oscarse-git/PSFB_1kW_Prototype/PSFB_PCB/BOM.xlsx

Sheet: BOM
Component | Name | Value | QTY | Price Unit | Need To Buy | Total Cost | URL
Capacitor | 1206B105K500CT | 1u | 12 | 0.72 € | 1 | 8.68 € | https://dk.farnell.com/multicomp-pro/1206b105k500ct/cap-1-f-50v-10-x7r-1206/dp/2497080
Capacitor | LKDM5102J271MF | 270u | 8 |  | 1 | 0.00 €
Capacitor | MAAST32MSB7226MPNA01 | 22u | 3 | 0.50 € | 1 | 1.50 € | https://eu.mouser.com/es/ProductDetail/TAIYO-YUDEN/MAAST32MSB7226MPNA01?qs=FmjOKN4Os876lp2kR04m7Q%3D%3D
Capacitor | C1608X7S1C225K080AE | 2.2u | 2 | 0.29 € | 1 | 0.58 € | https://eu.mouser.com/es/ProductDetail/TDK/C1608X7S1C225K080AE
Capacitor | 1812B104K631CT | 100n | 9 | 0.29 € | 1 | 2.65 € | https://eu.mouser.com/es/ProductDetail/Walsin/1812B104K631CT?qs=fIkAfuXiAQJoiEkNCtFvoQ%3D%3D
Capacitor | GRM1885C1H1R7WA01D | 1.7p | 2 | 0.29 € | 1 | 0.58 € | https://eu.mouser.com/es/ProductDetail/Murata-Electronics/GRM1885C1H1R7WA01D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
Capacitor | CL31B106KAHNNNF | 10u | 2 | 0.24 € | 1 | 0.49 € | https://eu.mouser.com/es/ProductDetail/Samsung-Electro-Mechanics/CL31B106KAHNNNF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
Capacitor | AC0402KPX7R7BB473 | 47n (X7R, 16V) | 4 | 0.05 € | 1 | 0.19 € | https://eu.mouser.com/es/ProductDetail/YAGEO/AC0402KPX7R7BB473
Capacitor | ECA-2EHG010B | 1u 250V | 1 | 0.43 € | 1 | 0.43 € | https://eu.mouser.com/es/ProductDetail/Panasonic-Industry/ECA-2EHG010B
Capacitor | CEU3E2X7R1H473M080AE | 47n (X7R, 50V) | 2 | 0.07 € | 1 | 0.14 € | https://eu.mouser.com/es/ProductDetail/TDK/CEU3E2X7R1H473M080AE?qs=xLDY6iXSiQaAymqHkImCEA%3D%3D
Capacitor | MAJCU168BB7104KTEA01 | 100n (X7R) | 2 | 0.27 € | 1 | 0.53 € | https://eu.mouser.com/es/ProductDetail/TAIYO-YUDEN/MAJCU168BB7104KTEA01?qs=ZcfC38r4PovJ4zMRJqa98Q%3D%3D
Capacitor | KAM31GR71H475KL | 4.7u (X7R) | 2 | 0.55 € | 1 | 1.10 € | https://eu.mouser.com/es/ProductDetail/KYOCERA-AVX/KAM31GR71H475KL?qs=Jm2GQyTW%2FbjSbY1tCxiE1g%3D%3D
Capacitor | 06035C470JAT2A | 47p | 1 | 0.20 € | 1 | 0.20 € | https://eu.mouser.com/es/ProductDetail/KYOCERA-AVX/06035C470JAT2A?qs=ZBeOGGPQgEHmipGwrPVCwg%3D%3D
SiC Diode | C3D10065A | S3D10065A | 4 | 2.60 € | 1 | 10.40 € | https://eu.mouser.com/es/ProductDetail/Wolfspeed/C3D10065A?qs=D3QG1iK7FqgMAdW1WuL7Qg%3D%3D
Diode | STTH1R06A | STTH1R06 | 2 | 0.67 € | 1 | 1.34 € | https://eu.mouser.com/es/ProductDetail/STMicroelectronics/STTH1R06A?qs=kndcJBrKlnTzl3o%252BhwomPg%3D%3D
LED | VLMTG1400-GS08 | LED GREEN | 5 | 0.36 € | 1 | 1.80 € | https://eu.mouser.com/es/ProductDetail/Vishay-Semiconductors/VLMTG1400-GS08
LED | 150120RS75000 | LED RED | 1 | 0.20 € | 1 | 0.20 € | https://eu.mouser.com/es/ProductDetail/Wurth-Elektronik/150120RS75000?qs=2kOmHSv6VfSstSh2FOQbDw%3D%3D
LED | 150120AS75000 | LED AMBAR | 1 | 0.20 € | 1 | 0.20 € | https://eu.mouser.com/es/ProductDetail/Wurth-Elektronik/150120AS75000
TVS Diode | ESD441DPLR | ESD441DPLR | 2 | 0.31 € | 1 | 0.62 € | https://eu.mouser.com/es/ProductDetail/Texas-Instruments/ESD441DPLR?qs=1Kr7Jg1SGW9UQFJqGMkN7Q%3D%3D
Ferrite Bead | BLM18PG121SN1D | FerriteBead | 1 | 0.12 € | 1 | 0.12 € | https://eu.mouser.com/es/ProductDetail/Murata-Electronics/BLM18PG121SN1D?qs=tY8e8KZalarVxhnmnUYZ1A%3D%3D
Current Sensor | TMCS1133B7AQDVGR | TMCS1133B7AQDVGR | 2 | 5.05 € | 1 | 10.10 € | https://eu.mouser.com/es/ProductDetail/Texas-Instruments/TMCS1133B7AQDVGR
Optocoupler | HCNR201-300E | HCNR201-300E | 1 | 5.47 € | 1 | 5.47 € | https://eu.mouser.com/es/ProductDetail/Broadcom-Avago/HCNR201-300E?qs=xnajaXqBF9%2Fpqjck28%2FBeQ%3D%3D
OpAmp | OPA356AIDBVT | OPA356AIDBVT | 2 | 2.49 € | 1 | 4.98 € | https://eu.mouser.com/es/ProductDetail/Texas-Instruments/OPA356AIDBVT?qs=7nS3%252BbEUL6sNJlEi0818Dw%3D%3D
AND gate | SN74LVC1G08DBVR | SN74LVC1G08DBVR | 1 | 0.10 € | 1 | 0.10 € | https://eu.mouser.com/es/ProductDetail/Texas-Instruments/SN74LVC1G08DBVR?qs=8yeEWhuAOtNjtL049wSCoQ%3D%3D
Comparator | TLV1702AIDGK | TLV1702AIDGK | 1 | 1.88 € | 1 | 1.88 € | https://eu.mouser.com/en/ProductDetail/Texas-Instruments/TLV1702AIDGK
OpAmp | OPA2376AQDRQ1 | OPA2376AQDRQ1 | 2 | 3.00 € | 1 | 6.00 € | https://eu.mouser.com/en/ProductDetail/Texas-Instruments/OPA2376AQDRQ1
Voltage Reg | LTC3639HMSE#PBF | LTC3639HMSE#PBF | 1 | 12.79 € | 1 | 12.79 € | https://eu.mouser.com/es/ProductDetail/Analog-Devices/LTC3639HMSEPBF?qs=hVkxg5c3xu91%2FQQCRu4j6Q%3D%3D
Isolated USB Repeater | ISOUSB111DWXR | ISOUSB111DWXR | 1 | 6.06 € | 1 | 6.06 € | https://eu.mouser.com/es/ProductDetail/Texas-Instruments/ISOUSB111DWXR?qs=Y0Uzf4wQF3msEozH7EwD3g%3D%3D
Buck Converter | TPS561246DRLR | TPS561246DRLR | 1 | 0.21 € | 1 | 0.21 € | https://www.mouser.dk/en/ProductDetail/Texas-Instruments/TPS561246DRLR?qs=IKkN%2F947nfBlLn983Qr7Pw%3D%3D
Screw Terminal | 1546551-2 | Power_Terminal_12V | 1 | 1.72 € | 1 | 1.72 € | https://eu.mouser.com/es/ProductDetail/TE-Connectivity/1546551-2?qs=m%2FhmcwQ75LmjcSTRMY1QVQ%3D%3D
Screw Terminal | 1731734 | Power in out | 2 | 2.92 € | 1 | 5.84 € | https://eu.mouser.com/es/ProductDetail/Phoenix-Contact/1731734?qs=5W%252BNKB25SvJ2jkw4aA1wOA%3D%3D
Pin Header | M20-9994046 | All Debug Pins | 1 | 1.39 € | 1 | 1.39 € | https://eu.mouser.com/es/ProductDetail/Harwin/M20-9994046?qs=sGAEpiMZZMvlX3nhDDO4AAIUUFD6r3d5s80vUO3Nluo%3D
Inductor | 784777471 | 470u | 1 | 2.16 € | 1 | 2.16 € | https://eu.mouser.com/es/ProductDetail/Wurth-Elektronik/784777471?qs=sBf%2Fb4nBSldQtXk2HMFhEg%3D%3D
Inductor | 74437349022 | 2.2uH 12mOhm | 1 | 1.99 € | 1 | 1.99 € | https://eu.mouser.com/es/ProductDetail/Wurth-Elektronik/74437349022?qs=cFlH0mFHHFpHkKN4ohgwvw%3D%3D
Mosfets | R6086YNZ4C13 | R6086YNZ4C13 | 2 | 10.93 € | 1 | 21.86 € | https://eu.mouser.com/es/ProductDetail/ROHM-Semiconductor/R6086YNZ4C13?qs=OcgtsXO%252B3gtDlrXNFpjj%2FQ%3D%3D
Resistor | MR06X7321FTL | 7.23k | 1 | 0.14 € | 1 | 0.14 € | https://eu.mouser.com/es/ProductDetail/Walsin/MR06X7321FTL
Resistor | RC0805JR-07150RL | 150 | 1 | 0.09 € | 1 | 0.09 € | https://eu.mouser.com/es/ProductDetail/YAGEO/RC0805JR-07150RL?qs=KyGMWp10Ukuj2ys2qNRVFA%3D%3D
Resistor | RMC16K303FTP | 30k | 3 | 0.19 € | 1 | 0.57 € | https://eu.mouser.com/es/ProductDetail/Kamaya/RMC16K303FTP
Resistor | RN73R2ATTD3002B25 | 30k | 2 | 0.15 € | 1 | 0.30 € | https://eu.mouser.com/es/ProductDetail/KOA-Speer/RN73R2ATTD3002B25?qs=2WXlatMagcHCGZgT8P9O6w%3D%3D
Resistor | RC0603FR-1333KL | 33k | 1 | 0.09 € | 1 | 0.09 € | https://eu.mouser.com/es/ProductDetail/YAGEO/RC0603FR-1333KL
Resistor | CRCW06031K00FKEI | 1k | 4 | 0.21 € | 1 | 0.86 € | https://eu.mouser.com/es/ProductDetail/Vishay/CRCW06031K00FKEI
Resistor | ERJ-PC3B6800V | 680 | 1 | 0.15 € | 1 | 0.15 € | https://eu.mouser.com/es/ProductDetail/Panasonic-Industry/ERJ-PC3B6800V?qs=G4MbTVxgV4Elo1Xzy%252BH5Rw%3D%3D
Resistor | ERJ-UP3F2R20V | 2.2 | 1 | 0.24 € | 1 | 0.24 € | https://eu.mouser.com/es/ProductDetail/Panasonic-Industry/ERJ-UP3F2R20V?qs=y9%2FpVxnqej8wd3GPnjpGVA%3D%3D
Resistor | ERJ-UP6F3R30V | 3.3 | 2 | 0.25 € | 1 | 0.50 € | https://eu.mouser.com/es/ProductDetail/Panasonic-Industry/ERJ-UP6F3R30V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
Resistor | RMC1/16-1002FTP | 10k | 25 | 0.15 € | 1 | 3.65 € | https://eu.mouser.com/es/ProductDetail/Kamaya/RMC1-16-1002FTP
Resistor | 560112116072 | 180k | 1 | 0.09 € |  | 0.09 € | https://eu.mouser.com/es/ProductDetail/Wurth-Elektronik/560112116072
Resistor | 560112116065 | 1.3k | 1 | 0.09 € |  | 0.09 € | https://eu.mouser.com/es/ProductDetail/Wurth-Elektronik/560112116065
Resistor | CR0603-JW-151ELF | 150 | 4 | 0.09 € |  | 0.34 € | https://eu.mouser.com/es/ProductDetail/Bourns/CR0603-JW-151ELF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
Resistor | CR0603-JW-271ELF | 270 | 2 | 0.09 € |  | 0.18 € | https://eu.mouser.com/es/ProductDetail/Bourns/CR0603-JW-271ELF
Resistor | RE0603FRE075K1L | 5.1k | 2 | 0.12 € | 1 | 0.24 € | https://eu.mouser.com/es/ProductDetail/YAGEO/RE0603FRE075K1L
Resistor | RT1206FRE07100KL | 100k | 6 | 0.02 € | 1 | 0.13 € | https://eu.mouser.com/es/ProductDetail/YAGEO/RT1206FRE07100KL
Resistor | RMC1/16K1353FTP | 135k | 1 | 0.15 € |  | 0.15 € | https://eu.mouser.com/es/ProductDetail/Kamaya/RMC1-16K1353FTP?qs=GedFDFLaBXH%2FiaXqy0n1Hw%3D%3D
Resistor | CR0603-JW-182ELF | 1.8k | 1 | 0.09 € | 1 | 0.09 € | https://eu.mouser.com/es/ProductDetail/Bourns/CR0603-JW-182ELF
Potentiometer | PVG3A104C01R00 | 100k | 1 | 1.06 € | 1 | 1.06 € | https://eu.mouser.com/es/ProductDetail/Bourns/PVG3A104C01R00?qs=v12b4BliScycgWcSTRg0kw%3D%3D
Push Button | FSM2JSMAATR | SW_MEC_5G | 1 | 0.28 € | 1 | 0.28 € | https://eu.mouser.com/es/ProductDetail/TE-Connectivity-Alcoswitch/FSM2JSMAATR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
Transformer Core |  | Transformer Core |  |  |  | 0.00 €
MCU | STM32G474CBT6 | STM32G474CBTx | 1 | 7.22 € | 1 | 7.22 € | https://eu.mouser.com/es/ProductDetail/STMicroelectronics/STM32G474CBT6?qs=BJlw7L4Cy79CZZusGsWPhQ%3D%3D
Mosfets | MASTERGAN6TR | MASTERGAN6TR | 2 | 8.03 € | 1 | 16.06 € | https://eu.mouser.com/es/ProductDetail/STMicroelectronics/MASTERGAN6TR?qs=4dK74SdgGtwzDTtkoTE%252BnA%3D%3D
Relay Driver | TPSI3050DWZR | TPSI3050DWZR | 1 | 3.97 € | 1 | 3.97 € | https://eu.mouser.com/es/ProductDetail/Texas-Instruments/TPSI3050DWZR?qs=IPgv5n7u5QZU8a0pRpRx4Q%3D%3D
Optocoupler | ACPL-M61L-000E | ACPL-M61L-000E | 1 | 2.73 € | 1 | 2.73 € | https://eu.mouser.com/es/ProductDetail/Broadcom-Avago/ACPL-M61L-000E?qs=YFzrHcMGcrvOVUT9y59Zbw%3D%3D
 |  |  |  |  |  | 153.51 €
 |  |  |  |  |  | 1146.74 DKK

Sheet: PSFB
Reference | Qty | Value | DNP | Exclude from BOM | Exclude from Board | Footprint | Datasheet
C1,C2,C3,C4,C5,C15,C16,C17,C24,C26,C44,C48 | 12 | 1u |  |  |  | Capacitor_SMD:C_1206_3216Metric | ~
C6,C13,C19 | 3 | 22u |  |  |  | Capacitor_SMD:C_1206_3216Metric | ~
C10,C11,C12,C14,C28,C49,C54,C55 | 8 | 270u |  |  |  | Capacitor_THT:CP_Radial_D25.0mm_P10.00mm_SnapIn | ~
C18,C42 | 2 | 2.2u |  |  |  | Capacitor_SMD:C_0603_1608Metric_Pad1.08x0.95mm_HandSolder | ~
C20,C25,C27,C43,C45,C46,C47,C50,C53 | 9 | 100n |  |  |  | Capacitor_SMD:C_1812_4532Metric | ~
C21,C22 | 2 | 1.7p |  |  |  | Capacitor_SMD:C_0603_1608Metric_Pad1.08x0.95mm_HandSolder | ~
C23,C51 | 2 | 10u |  |  |  | Capacitor_SMD:C_1206_3216Metric | ~
C29 | 1 | C |  |  |  |  | ~
C30,C33,C38,C39 | 4 | 47n (X7R, 16V) |  |  |  | Capacitor_SMD:C_0402_1005Metric | ~
C31 | 1 | 1u 250V |  |  |  | Capacitor_THT:CP_Radial_Tantal_D7.0mm_P5.00mm | ~
C32 | 1 | 10u |  |  |  | Capacitor_SMD:C_1206_3216Metric_Pad1.33x1.80mm_HandSolder | ~
C34,C37 | 2 | 47n (X7R, 50V) |  |  |  | Capacitor_SMD:C_0603_1608Metric | ~
C35,C41 | 2 | 100n (X7R) |  |  |  | Capacitor_SMD:C_0603_1608Metric_Pad1.08x0.95mm_HandSolder | ~
C36,C40 | 2 | 4.7u (X7R) |  |  |  | Capacitor_SMD:C_1206_3216Metric_Pad1.33x1.80mm_HandSolder | ~
C52 | 1 | 47p |  |  |  | Capacitor_SMD:C_0603_1608Metric_Pad1.08x0.95mm_HandSolder | ~
D1,D2,D3,D4 | 4 | S3D10065A |  |  |  | Package_TO_SOT_THT:TO-220-2_Vertical | https://www.wolfspeed.com/media/downloads/73/C3D10065A.pdf
D5,D6 | 2 | STTH1R06 |  |  |  | oscar:DIOM5126X265N | https://www.diodes.com/assets/Datasheets/ds30396.pdf
D7,D8,D9,D14,D15 | 5 | LED GREEN |  |  |  | LED_SMD:LED_0603_1608Metric | ~
D10 | 1 | LED RED |  |  |  | LED_SMD:LED_0603_1608Metric | ~
D11 | 1 | LED AMBAR |  |  |  | LED_SMD:LED_0603_1608Metric | ~
D12,D13 | 2 | ESD441DPLR |  |  |  | oscar:ESD441DPLR | https://www.onsemi.com/pdf/datasheet/esd5z2.5t1-d.pdf
FB1 | 1 | FerriteBead |  |  |  | Resistor_SMD:R_0201_0603Metric | ~
IC1,IC9 | 2 | TMCS1133B7AQDVGR |  |  |  | oscar:TMCS1133B7AQDVGR | https://www.ti.com/product/TMCS1133#design-development
IC2 | 1 | HCNR201-300E |  |  |  | oscar:HCNR201300E | https://datasheet.datasheetarchive.com/originals/distributors/Datasheets-6/DSA-115859.pdf
IC3,IC4 | 2 | OPA356AIDBVT |  |  |  | oscar:SOT95P280X145-5N | http://www.ti.com/lit/gpn/opa356
IC5 | 1 | SN74LVC1G08DBVR |  |  |  | oscar:SOT95P280X145-5N | http://www.ti.com/lit/ds/symlink/sn74lvc1g08.pdf
IC6 | 1 | TLV1702AIDGK |  |  |  | oscar:SOP65P490X110-8N | http://www.ti.com/lit/ds/symlink/tlv1702.pdf
IC7 | 1 | OPA2376AQDRQ1 |  |  |  | SOIC127P600X175-8N | http://www.ti.com/lit/gpn/opa2376-q1
IC8 | 1 | LTC3639HMSE#PBF |  |  |  | oscar:LTC3639HMSEPBF | https://www.analog.com/media/en/technical-documentation/data-sheets/3639fd.pdf
IC10 | 1 | ISOUSB111DWXR |  |  |  | oscar:SOP65P1030X260-16N | https://www.ti.com/lit/ds/symlink/isousb111.pdf?ts=1669697942868
IC11 | 1 | TPS561246DRLR |  |  |  | oscar:SOTFL50P160X60-6N | https://www.ti.com/lit/ds/symlink/tps561246.pdf?ts=1736141056725
IC12 | 1 | TPSI3050DWZR |  |  |  | oscar:SOIC127P1150X280-8N | https://www.ti.com/lit/ds/symlink/tpsi3050.pdf?ts=1725435583662
J2 | 1 | GND_S |  |  |  | Connector_PinHeader_2.54mm:PinHeader_1x01_P2.54mm_Vertical | ~
J3 | 1 | JUMPER_BOOT |  |  |  | Connector_PinHeader_2.54mm:PinHeader_1x02_P2.54mm_Vertical | ~
J4 | 1 | 3.3_PIN_IN_DEBUG |  |  |  | Connector_PinHeader_2.54mm:PinHeader_1x02_P2.54mm_Vertical | ~
J5 | 1 | STLINK_PIN |  |  |  | Connector_PinHeader_2.54mm:PinHeader_1x05_P2.54mm_Vertical | ~
J6 | 1 | USB_C |  |  |  | oscar:UJ20CHGMSMT4BP16TR | https://www.sameskydevices.com/product/resource/uj20-c-h-g-msmt-4b-p16-tr.pdf
J7 | 1 | Power_Terminal_12V |  |  |  | oscar:15465512 | ~
J8 | 1 | 12V_Jumper_for_3.3V |  |  |  | Connector_PinHeader_2.54mm:PinHeader_1x02_P2.54mm_Vertical | ~
J9 | 1 | I_IN_SENSE |  |  |  | Connector_PinHeader_2.54mm:PinHeader_1x01_P2.54mm_Vertical | ~
J10 | 1 | V_IN_SENSE |  |  |  | Connector_PinHeader_2.54mm:PinHeader_1x01_P2.54mm_Vertical | ~
J11 | 1 | I_OUT_SENSE |  |  |  | Connector_PinHeader_2.54mm:PinHeader_1x01_P2.54mm_Vertical | ~
J12 | 1 | V_OUT_SENSE |  |  |  | Connector_PinHeader_2.54mm:PinHeader_1x01_P2.54mm_Vertical | ~
J13 | 1 | V_BAT_SENSE |  |  |  | Connector_PinHeader_2.54mm:PinHeader_1x01_P2.54mm_Vertical | ~
J14 | 1 | GND_SENSE |  |  |  | Connector_PinHeader_2.54mm:PinHeader_1x01_P2.54mm_Vertical | ~
J15 | 1 | CTRL_AH |  |  |  | Connector_PinHeader_2.54mm:PinHeader_1x01_P2.54mm_Vertical | ~
J16 | 1 | CTRL_AL |  |  |  | Connector_PinHeader_2.54mm:PinHeader_1x01_P2.54mm_Vertical | ~
J17 | 1 | CTRL_BL |  |  |  | Connector_PinHeader_2.54mm:PinHeader_1x01_P2.54mm_Vertical | ~
J18 | 1 | CTRL_BH |  |  |  | Connector_PinHeader_2.54mm:PinHeader_1x01_P2.54mm_Vertical | ~
J19 | 1 | HVDC_POWER_IN |  |  |  | oscar:1731734 | ~
J20 | 1 | 5VCC_S |  |  |  | Connector_PinHeader_2.54mm:PinHeader_1x01_P2.54mm_Vertical | ~
J21 | 1 | Vref_S |  |  |  | Connector_PinHeader_2.54mm:PinHeader_1x01_P2.54mm_Vertical | ~
J22 | 1 | VDC_S_SENSE_S |  |  |  | Connector_PinHeader_2.54mm:PinHeader_1x01_P2.54mm_Vertical | ~
J23 | 1 | VOUT_CHARGER |  |  |  | oscar:1731734 | ~
L1 | 1 | 470u |  |  |  | oscar:784777471 | ~
L2 | 1 | 2.2uH 12mOhm |  |  |  | oscar:WE-LHMI_7030_705048 | ~
Q1,Q2 | 2 | R6086YNZ4C13 |  |  |  | Package_TO_SOT_THT:TO-247-3_Vertical | https://ngspice.sourceforge.io/docs/ngspice-html-manual/manual.xhtml#cha_MOSFETs
R1 | 1 | 7.23k |  |  |  | Resistor_SMD:R_0603_1608Metric_Pad0.98x0.95mm_HandSolder | ~
R2 | 1 | 150 |  |  |  | Resistor_SMD:R_0805_2012Metric_Pad1.20x1.40mm_HandSolder | ~
R3,R4 | 2 | 30k |  |  |  | Resistor_SMD:R_0805_2012Metric_Pad1.20x1.40mm_HandSolder | ~
R5 | 1 | 33k |  |  |  | Resistor_SMD:R_0603_1608Metric_Pad0.98x0.95mm_HandSolder | ~
R6,R7,R10,R13 | 4 | 1k |  |  |  | Resistor_SMD:R_0603_1608Metric_Pad0.98x0.95mm_HandSolder | ~
R8 | 1 | 680 |  |  |  | Resistor_SMD:R_0603_1608Metric_Pad0.98x0.95mm_HandSolder | ~
R9,R11,R41 | 3 | 30k |  |  |  | Resistor_SMD:R_0603_1608Metric_Pad0.98x0.95mm_HandSolder | ~
R12 | 1 | 2.2 |  |  |  | Resistor_SMD:R_0603_1608Metric_Pad0.98x0.95mm_HandSolder | ~
R14,R21 | 2 | 3.3 |  |  |  | Resistor_SMD:R_0805_2012Metric_Pad1.20x1.40mm_HandSolder | ~
R15,R16,R17,R18,R19,R20,R24,R25,R39,R44,R45,R46,R47,R48,R49,R50,R51,R52,R53,R54,R55,R56,R57,R58,R59 | 25 | 10k |  |  |  | Resistor_SMD:R_0603_1608Metric_Pad0.98x0.95mm_HandSolder | ~
R22 | 1 | 180k |  |  |  | Resistor_SMD:R_0603_1608Metric_Pad0.98x0.95mm_HandSolder | ~
R23 | 1 | 1.3k |  |  |  | Resistor_SMD:R_0603_1608Metric_Pad0.98x0.95mm_HandSolder | ~
R26,R27,R28,R43 | 4 | 150 |  |  |  | Resistor_SMD:R_0603_1608Metric_Pad0.98x0.95mm_HandSolder | ~
R29,R30 | 2 | 270 |  |  |  | Resistor_SMD:R_0603_1608Metric_Pad0.98x0.95mm_HandSolder | ~
R31,R32 | 2 | 5.1k |  |  |  | Resistor_SMD:R_0603_1608Metric_Pad0.98x0.95mm_HandSolder | ~
R33,R34,R35,R36,R37,R38 | 6 | 100k |  |  |  | Resistor_SMD:R_1206_3216Metric_Pad1.30x1.75mm_HandSolder | ~
R40 | 1 | 135k |  |  |  | Resistor_SMD:R_0603_1608Metric_Pad0.98x0.95mm_HandSolder | ~
R42 | 1 | 1.8k |  |  |  | Resistor_SMD:R_0603_1608Metric_Pad0.98x0.95mm_HandSolder | ~
RV1 | 1 | 100k |  |  |  | oscar:PVG3A104C01R00 | ~
S1 | 1 | FSM2JSMAATR |  |  |  | oscar:FSM2J_1 | https://www.te.com/commerce/DocumentDelivery/DDEController?Action=srchrtrv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
TR1 | 1 | Our Transformer |  |  |  | Transformer_THT:Transformer_Breve_TEZ-28x33 | http://www.breve.pl/pdf/ANG/TEZ_ang.pdf
U1 | 1 | STM32G474CBTx |  |  |  | Package_QFP:LQFP-48_7x7mm_P0.5mm | https://www.st.com/resource/en/datasheet/stm32g474cb.pdf
U2,U4 | 2 | MASTERGAN6TR |  |  |  | oscar:QFN35_9X9_STM-M | https://www.st.com/resource/en/datasheet/mastergan6.pdf
U5 | 1 | ACPL-M61L-000E |  |  |  | oscar:SO-5_AVA-L | ACPL-M61L-000E

Sheet: Hoja1
TR driver | SN6507DGQR | https://www.mouser.com/es/ProductDetail/Texas-Instruments/SN6507DGQR?qs=vvQtp7zwQdOlI8FFS82ezA%3D%3D
TR driver | 750319690 | https://www.mouser.com/es/ProductDetail/Wurth-Elektronik/750319690?qs=1Kr7Jg1SGW%2Fxuc9sXU4Xvg%3D%3D
shocktty | BAT165E6327HTSA1 | https://www.mouser.com/es/ProductDetail/Infineon-Technologies/BAT165E6327HTSA1?qs=K00xGehIljtOiGvGDAvWFg%3D%3D
OPAMP | OPA365AIDBVTG4 | https://www.mouser.com/es/ProductDetail/Texas-Instruments/OPA365AIDBVTG4?qs=pJP364FAHqQWllaZFOaiyA%3D%3D
Vreg | UA78M05CDCYG3 | https://eu.mouser.com/es/ProductDetail/Texas-Instruments/UA78M05CDCYG3
Vreg | TPS561208DDCT | https://eu.mouser.com/es/ProductDetail/Texas-Instruments/TPS561208DDCT?qs=5aG0NVq1C4w3WPddB%252B2yhA%3D%3D
Cap 25V 0.1uF | 08053C104KAT2A | https://eu.mouser.com/es/ProductDetail/KYOCERA-AVX/08053C104KAT2A?qs=EihRZLdKnF2GcTBzDkE%2FiQ%3D%3D
Cap 47uF X7S
Bobina 3.3uH | 784777033 | https://eu.mouser.com/es/ProductDetail/Wurth-Elektronik/784777033?qs=sBf%2Fb4nBSldgShFgH6OSMg%3D%3D
TVS | RCLAMP0521H.C | https://www.mouser.dk/en/ProductDetail/Semtech/RCLAMP0521H.C?qs=jcD%2FCkGBYePZtUEAq397Aw%3D%3D
