oscarse-git/PSFB_1kW_Prototype/Tranformer_Calculator/check/auditoria_168_campos.csv

Referencia | Campo | Valor actual | Valor contrastado | Estado | PDF | Página | Localización | Evidencia / observación | SHA256 PDF
0T42019EC | id | 0T42019EC | 0T42019EC | Coincide | 0T42019EC.pdf | 1 | Specification for |  | 87266b2b87d6918433aff71a38bada4273ee3efb8cc4a9dd238926d39ba48ea0
0T42019EC | Bmax | 0.5 | 0.5 | Coincide | 0T42019EC.pdf | 1 | INDUCTANCE: Test conditions |  | 87266b2b87d6918433aff71a38bada4273ee3efb8cc4a9dd238926d39ba48ea0
0T42019EC | Ae | 29 | 29 | Coincide | 0T42019EC.pdf | 1 | Eff. Parameters: Amin |  | 87266b2b87d6918433aff71a38bada4273ee3efb8cc4a9dd238926d39ba48ea0
0T42019EC | Aw | 25.02 | 25.02 | Coincide | 0T42019EC.pdf | 1 | DIMENSIONS: tabla y dibujo | np.round(3.25 * 7.7, 2) | 87266b2b87d6918433aff71a38bada4273ee3efb8cc4a9dd238926d39ba48ea0
0T42019EC | Ve | 1460 | 1460 | Coincide | 0T42019EC.pdf | 1 | Eff. Parameters: Ve |  | 87266b2b87d6918433aff71a38bada4273ee3efb8cc4a9dd238926d39ba48ea0
0T42019EC | AL | 1540 | 1540 | Coincide | 0T42019EC.pdf | 1 | INDUCTANCE: nominal |  | 87266b2b87d6918433aff71a38bada4273ee3efb8cc4a9dd238926d39ba48ea0
0T42019EC | Ploss | 590 | 590 | Coincide | 0T42019EC.pdf | 1 | CORE LOSSES: PL max individual; 25°C, 100 kHz, 200 mT |  | 87266b2b87d6918433aff71a38bada4273ee3efb8cc4a9dd238926d39ba48ea0
0T44444EC | id | 0T44444EC | 0T44444EC | Coincide | 0T44444EC.pdf | 1 | Specification for |  | 0fd92a081d4de366ace3e511815b4f9ace898e87de8ffbb00830197078c8083e
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
0T40601TC | Ploss | 500 | 500 | Coincide | 0T40601TC.pdf | 1 | CORE LOSSES: PL max individual; 25°C, 100 kHz, 200 mT |  | 2723211623cb77d263b5b4174ed2ae3919ee3ba110f717a5925099e85e5c1a50
