oscarse-git/PSFB_1kW_Prototype/PSFB_PCB/Components/LIB_HCNR201-300E/HCNR201-300E/3D/HCNR201-300E.stp

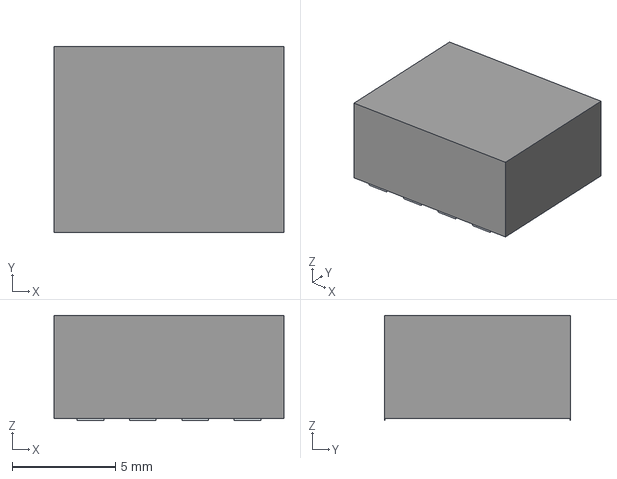
[picture p1: CAD file, 2026-10-29]
PSFB_PCB/Components/LIB_HCNR201-300E/HCNR201-300E/3D/HCNR201-300E.stp
11.2 x 9.00 x 5.10 mm
Pins
