oscarse-git/PSFB_1kW_Prototype/PSFB_PCB/Components/LIB_ISOUSB111DWXR/ISOUSB111DWXR/3D/ISOUSB111DWXR.stp

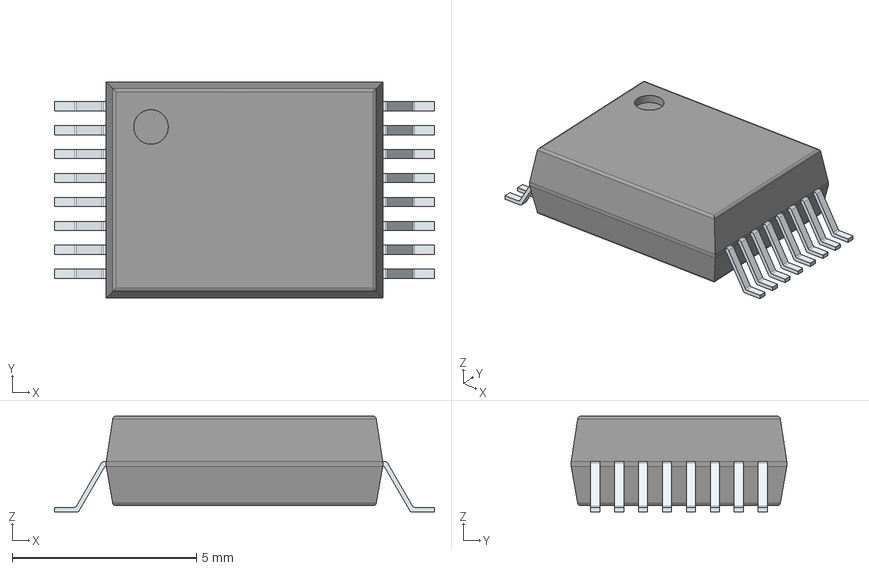
[picture p2: CAD file, 2026-10-29]
PSFB_PCB/Components/LIB_ISOUSB111DWXR/ISOUSB111DWXR/3D/ISOUSB111DWXR.stp
10.3 x 5.85 x 2.60 mm
PinsArrayLR
