oscarse-git/PSFB_1kW_Prototype/PSFB_PCB/Components/LIB_LTC3639HMSE#PBF/LTC3639HMSE#PBF/3D/LTC3639HMSE#PBF.stp

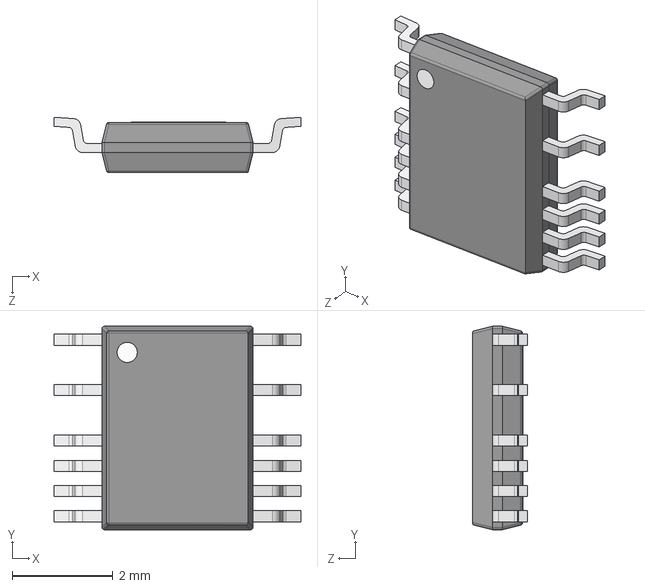
[picture p3: CAD file, 2026-10-29]
PSFB_PCB/Components/LIB_LTC3639HMSE#PBF/LTC3639HMSE#PBF/3D/LTC3639HMSE#PBF.stp
4.90 x 4.04 x 1.10 mm
