oscarse-git/PSFB_1kW_Prototype/PSFB_PCB/Components/LIB_PVG3A104C01R00/PVG3A104C01R00/3D/PVG3A104C01R00.stp

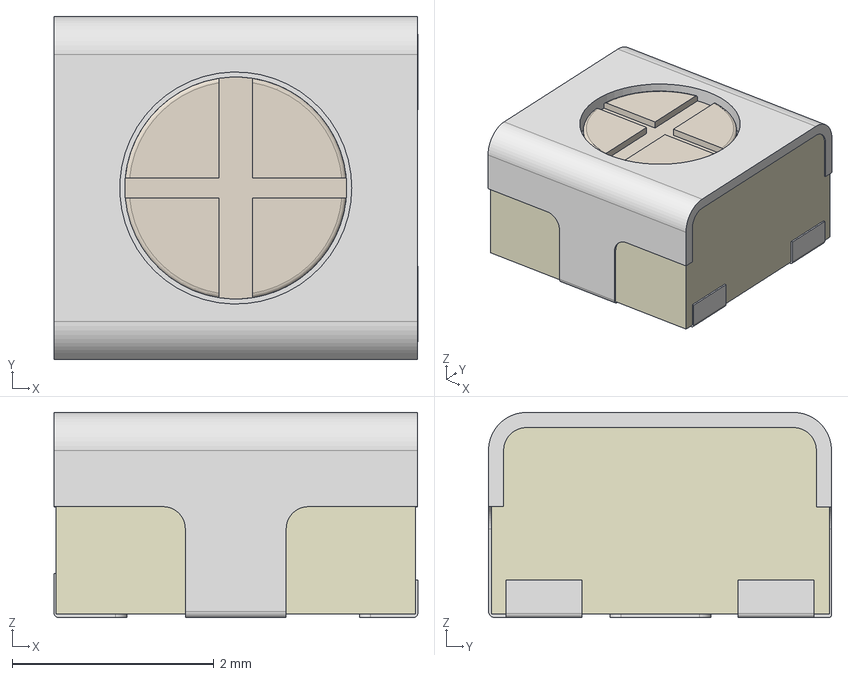
[picture p4: CAD file, 2026-10-29]
PSFB_PCB/Components/LIB_PVG3A104C01R00/PVG3A104C01R00/3D/PVG3A104C01R00.stp
3.60 x 3.40 x 2.03 mm
