oscarse-git/PSFB_1kW_Prototype/PSFB_PCB/Components/LIB_RCLAMP0521H.C/RCLAMP0521H.C/3D/RCLAMP0521H.C.stp

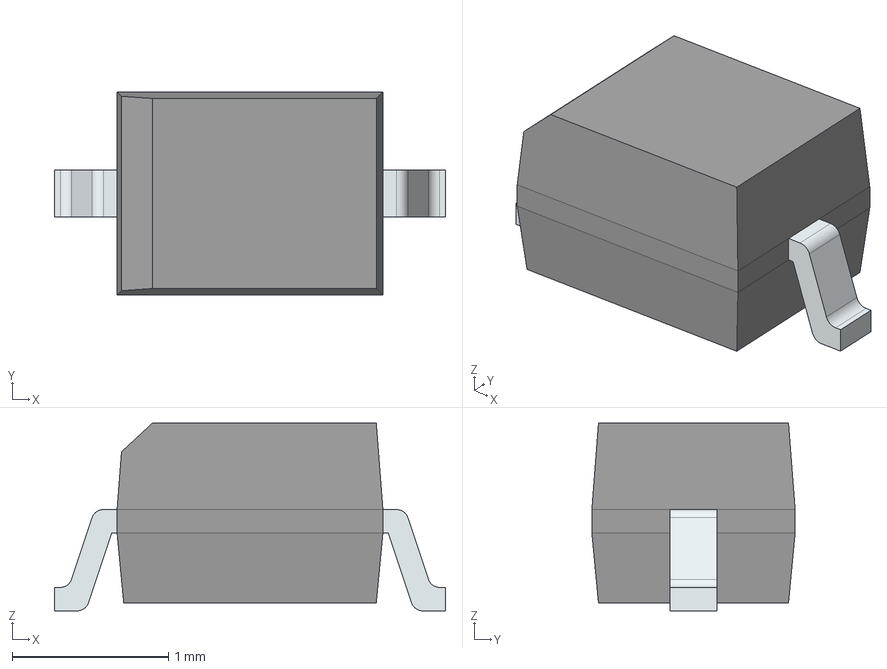
[picture p5: CAD file, 2026-11-10]
PSFB_PCB/Components/LIB_RCLAMP0521H.C/RCLAMP0521H.C/3D/RCLAMP0521H.C.stp
2.50 x 1.30 x 1.20 mm
FilletPinL
FilletPinR
