oscarse-git/PSFB_1kW_Prototype/PSFB_PCB/Components/LIB_TMCS1133B7AQDVGR/TMCS1133B7AQDVGR/3D/TMCS1133B7AQDVGR.stp

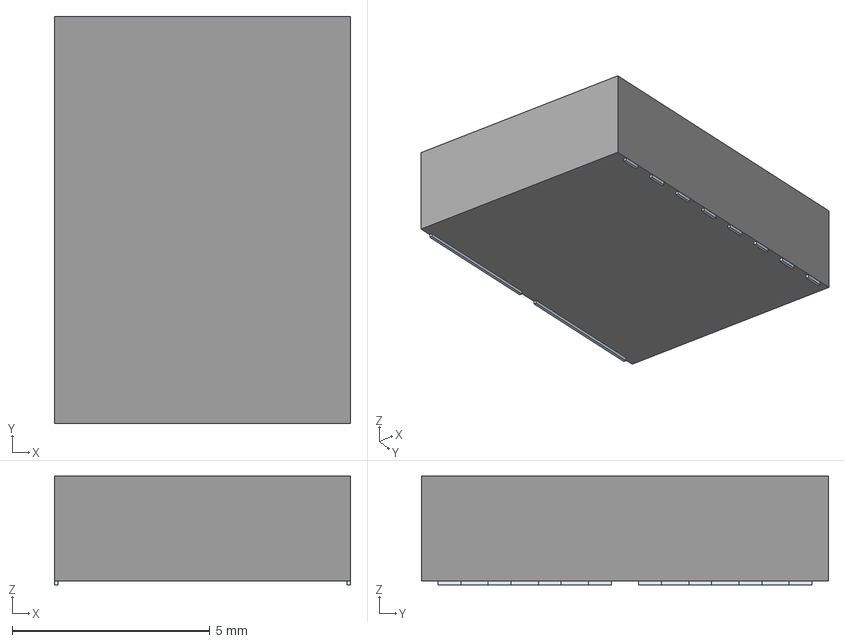
[picture p6: CAD file, 2026-10-29]
PSFB_PCB/Components/LIB_TMCS1133B7AQDVGR/TMCS1133B7AQDVGR/3D/TMCS1133B7AQDVGR.stp
7.50 x 10.3 x 2.75 mm
Pins
