oscarse-git/PSFB_1kW_Prototype/PSFB_PCB/Components/LIB_TPSI3050DWZR/TPSI3050DWZR/3D/TPSI3050DWZR.stp

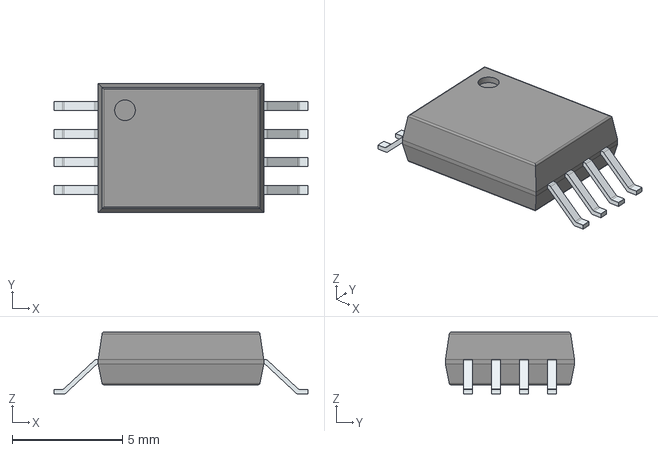
[picture p7: CAD file, 2026-10-29]
PSFB_PCB/Components/LIB_TPSI3050DWZR/TPSI3050DWZR/3D/TPSI3050DWZR.stp
11.5 x 5.85 x 2.80 mm
PinsArrayLR
