oscarse-git/PSFB_1kW_Prototype/PSFB_PCB/Components/LIB_1546551-2/1546551-2/3D/1546551-2.stp

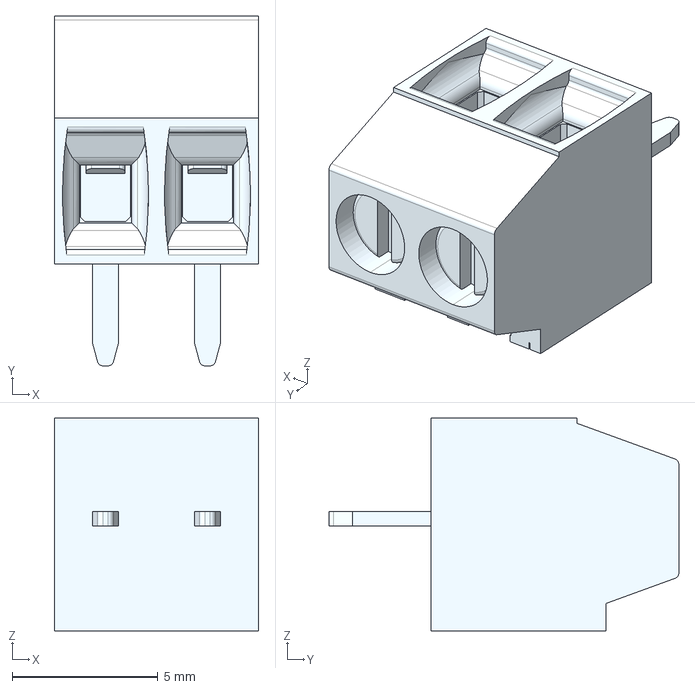
[picture p8: CAD file, 2026-10-29]
PSFB_PCB/Components/LIB_1546551-2/1546551-2/3D/1546551-2.stp
7.00 x 12.0 x 7.30 mm
