oscarse-git/PSFB_1kW_Prototype/PSFB_PCB/Components/LIB_1731734/1731734/3D/1731734.stp

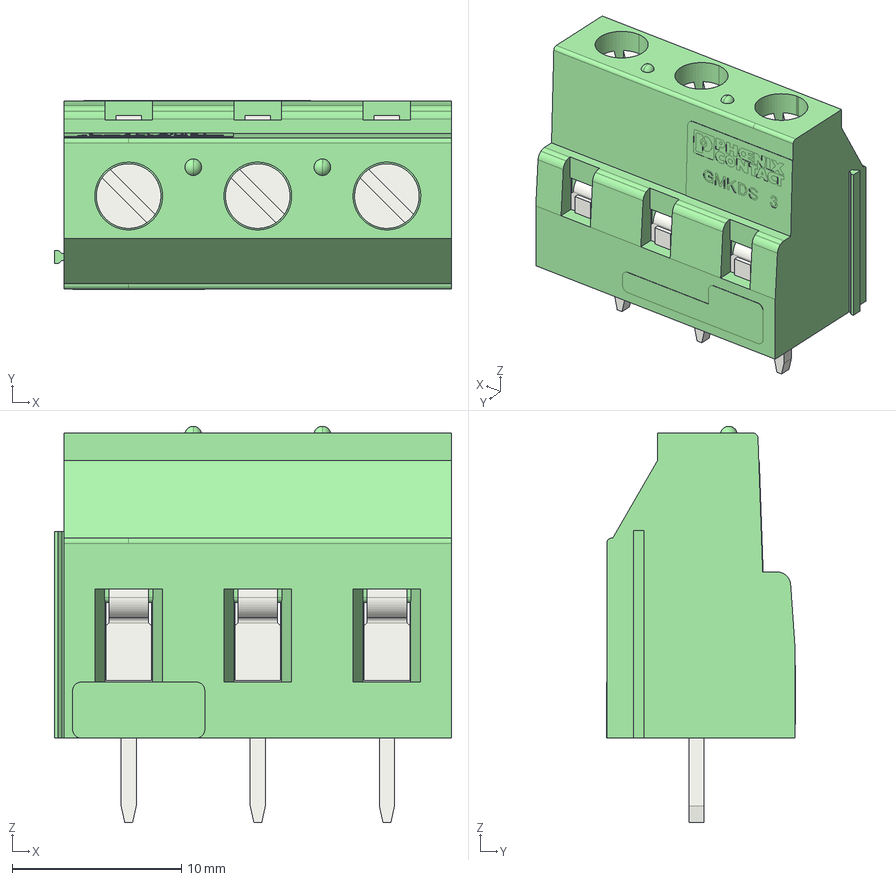
[picture p9: CAD file, 2026-10-29]
PSFB_PCB/Components/LIB_1731734/1731734/3D/1731734.stp
23.4 x 11.2 x 23.4 mm
