oscarse-git/PSFB_1kW_Prototype/PSFB_PCB/Components/LIB_784777033/784777033/3D/784777033.stp

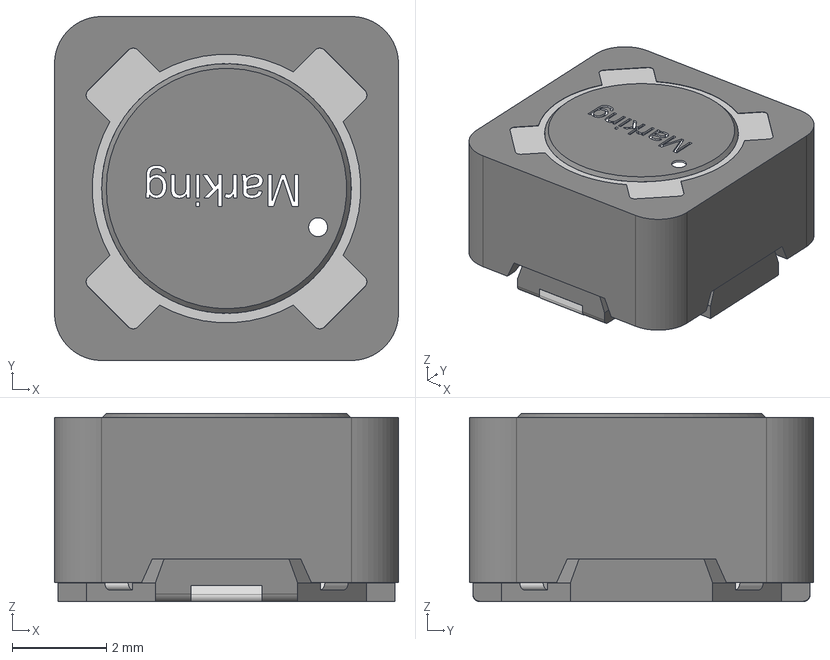
[picture p10: CAD file, 2026-10-30]
PSFB_PCB/Components/LIB_784777033/784777033/3D/784777033.stp
7.30 x 7.30 x 4.00 mm
Ferrite_5.3x3.6
Umspritzung_1
Glue
Ferrite-Ring7.3x3.5x5.7
Leadframe x 2
contact x 4
