oscarse-git/PSFB_1kW_Prototype/(list of files, cad)

Other CAD files:
PSFB_PCB/Components/LIB_RCLAMP0521H.C/RCLAMP0521H.C/Allegro/sod2513x120n.psm
PSFB_PCB/Components/LIB_RCLAMP0521H.C/RCLAMP0521H.C/DEHDL/rclamp0521h.c/chips/chips.prt
