oscarse-git/PSFB_1kW_Prototype/PSFB_PCB/SCH_Schematic1_2026-09-29.pdf

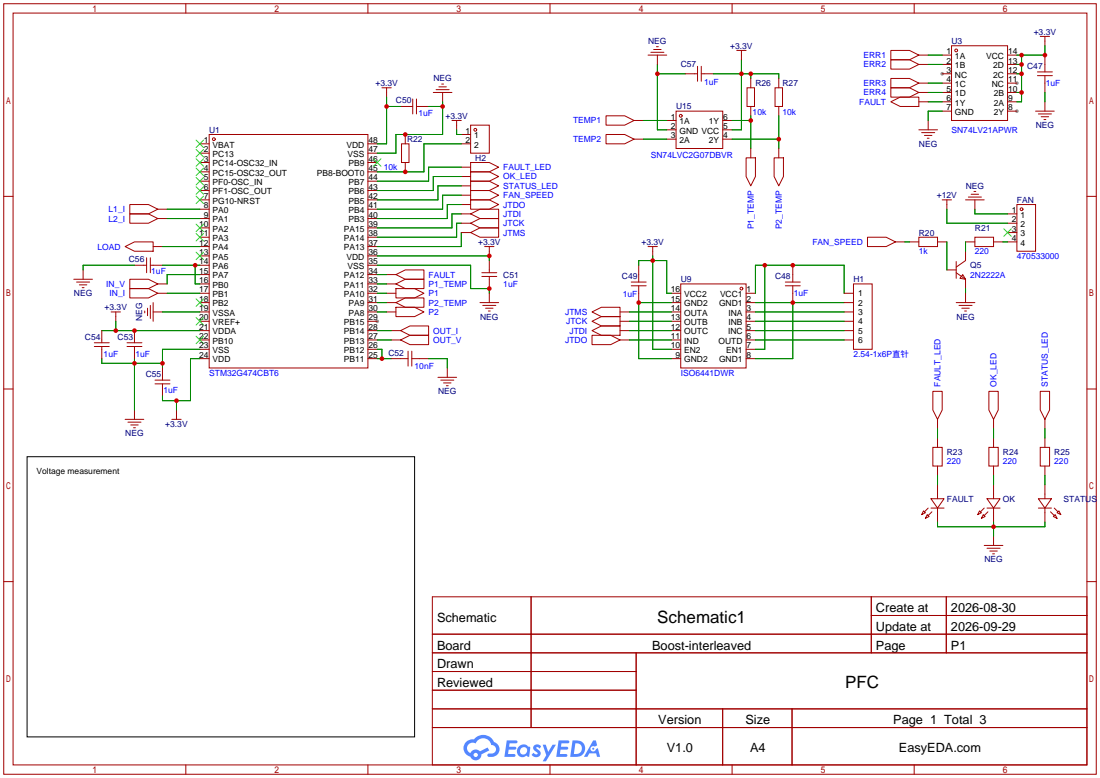
[picture p11: page 1]

EN2 10 IND 11 OUTC 12 OUTB 13 OUTA 14 GND2 15 VCC2 16

Schematic | Schematic1 | Create at | 2026-08-30

Update at | 2026-09-29

Board | Boost-interleaved | Page | P1
Drawn | | PFC
Reviewed

Version | Size | Page 1 Total 3
V1.0 | A4 | EasyEDA.com

# PRE_POS+PRE_POS⁺

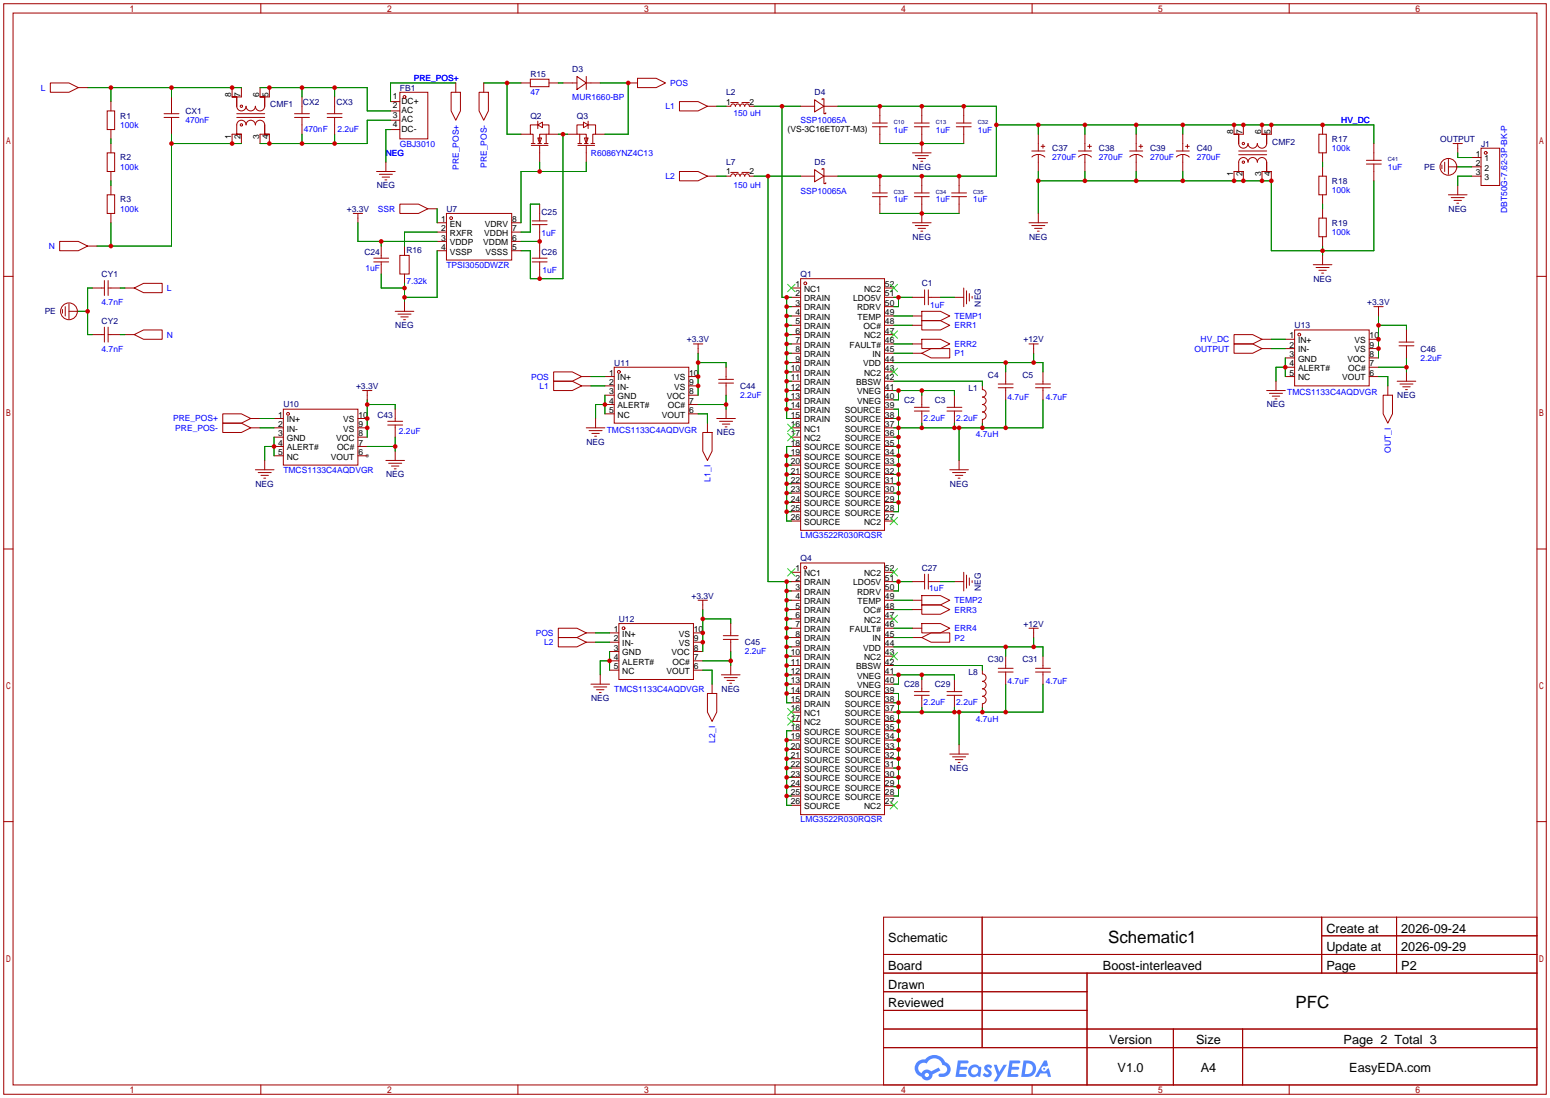
[picture p12: page 2]

DRAIN 2
DRAIN 3
DRAIN 4
DRAIN 5
DRAIN 6
DRAIN 7
DRAIN 8
NC2 27 SOURCE 26 SOURCE 25 SOURCE 24 SOURCE 23 SOURCE 22 SOURCE 21 SOURCE 20 SOURCE 19 SOURCE 18 NC2 17 NC1 16 DRAIN 15 DRAIN 14 DRAIN 13 DRAIN 12 DRAIN 11 DRAIN 10 DRAIN 9

Schematic | Schematic1 | Create at | 2026-09-24

Update at | 2026-09-29

Board | Boost-interleaved | Page | P2
Drawn | | PFC
Reviewed

N1 N2

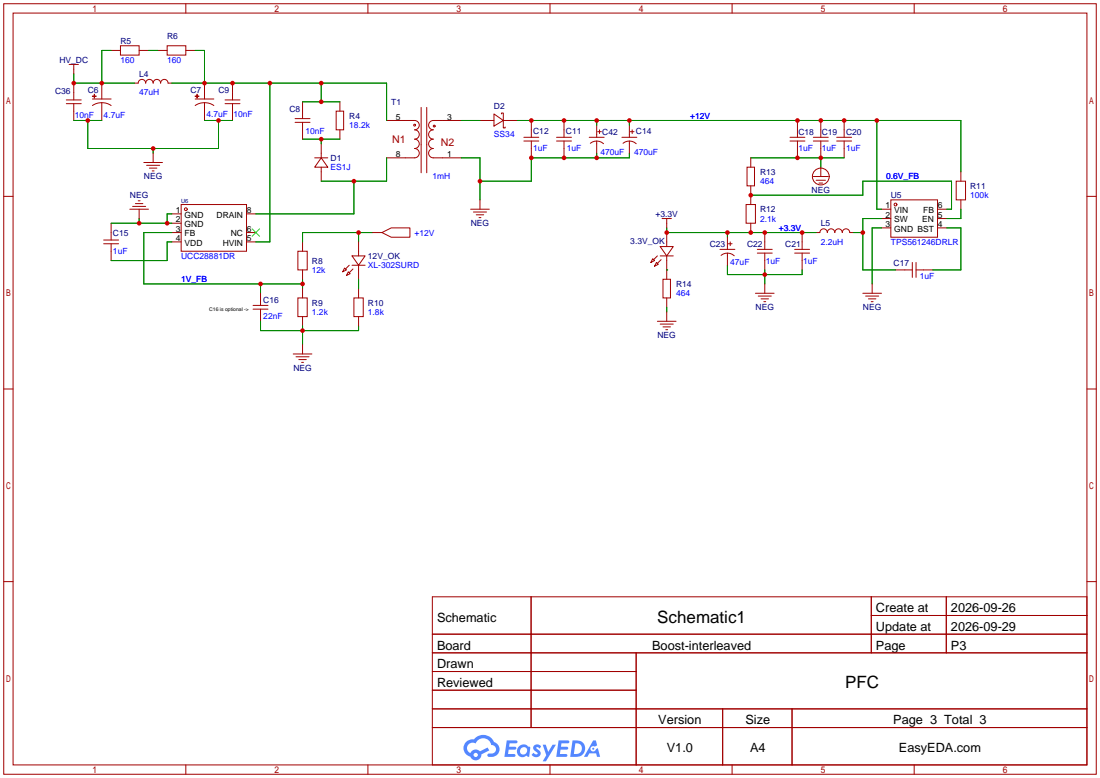
[picture p13: page 3]

Schematic | Schematic1 | Create at | 2026-09-26

Update at | 2026-09-29

Board | Boost-interleaved | Page | P3
Drawn | | PFC
Reviewed
