oscarse-git/PSFB_1kW_Prototype/PSFB_PCB/PSFB.pdf

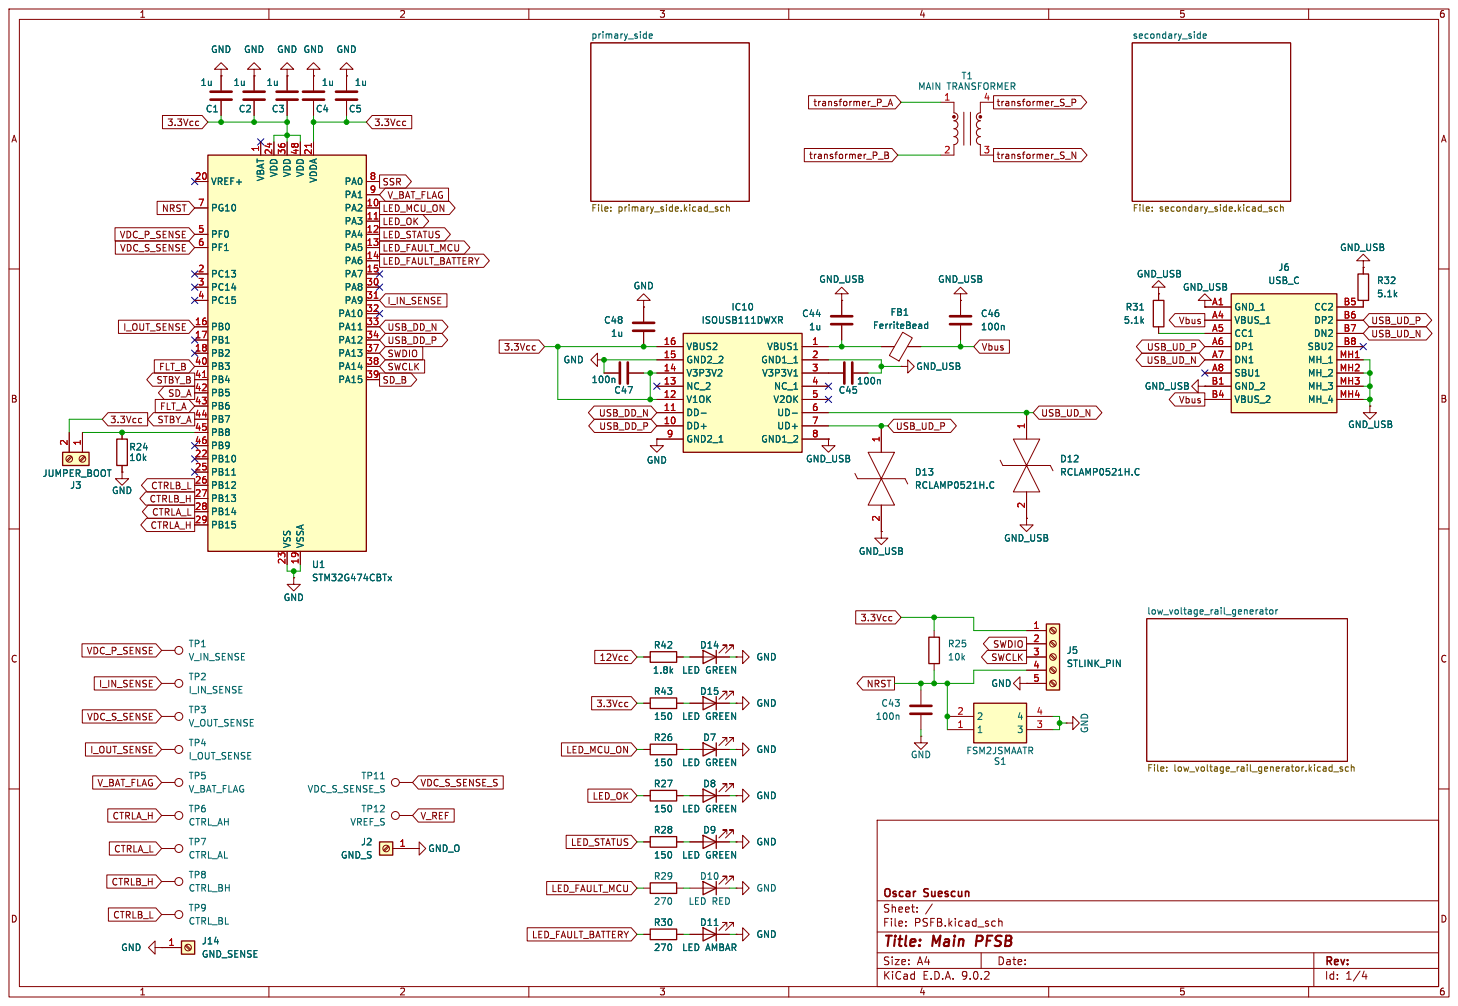
[picture p14: page 1]

1 VDD 24 VDD 36 VSS 23 VDD 48 VSSA 19 VDDA 21 PA0 8 PA1 9 PA2 10 PA3 11 PA4 12 PA5 13 PA6 14 PA7 15 PA8 30 PA9 31 PA10 32 PA11 33 PA12 34 PA13 37 PA14 38 PA15 39 U1STM32G474CBTx C48

1 VDD 24 VDD 36 VSS 23 VDD 48 VSSA 19 VDDA 21 PA0 8 PA1 9 PA2 10 PA3 11 PA4 12 PA5 13 PA6 14 PA7 15 PA8 30 PA9 31 PA10 32 PA11 33 PA12 34 PA13 37 PA14 38 PA15 39 D7

File: PSFB.kicad_sch Sheet: / Oscar Suescun

Id: 1/4 Title: Main PFSB

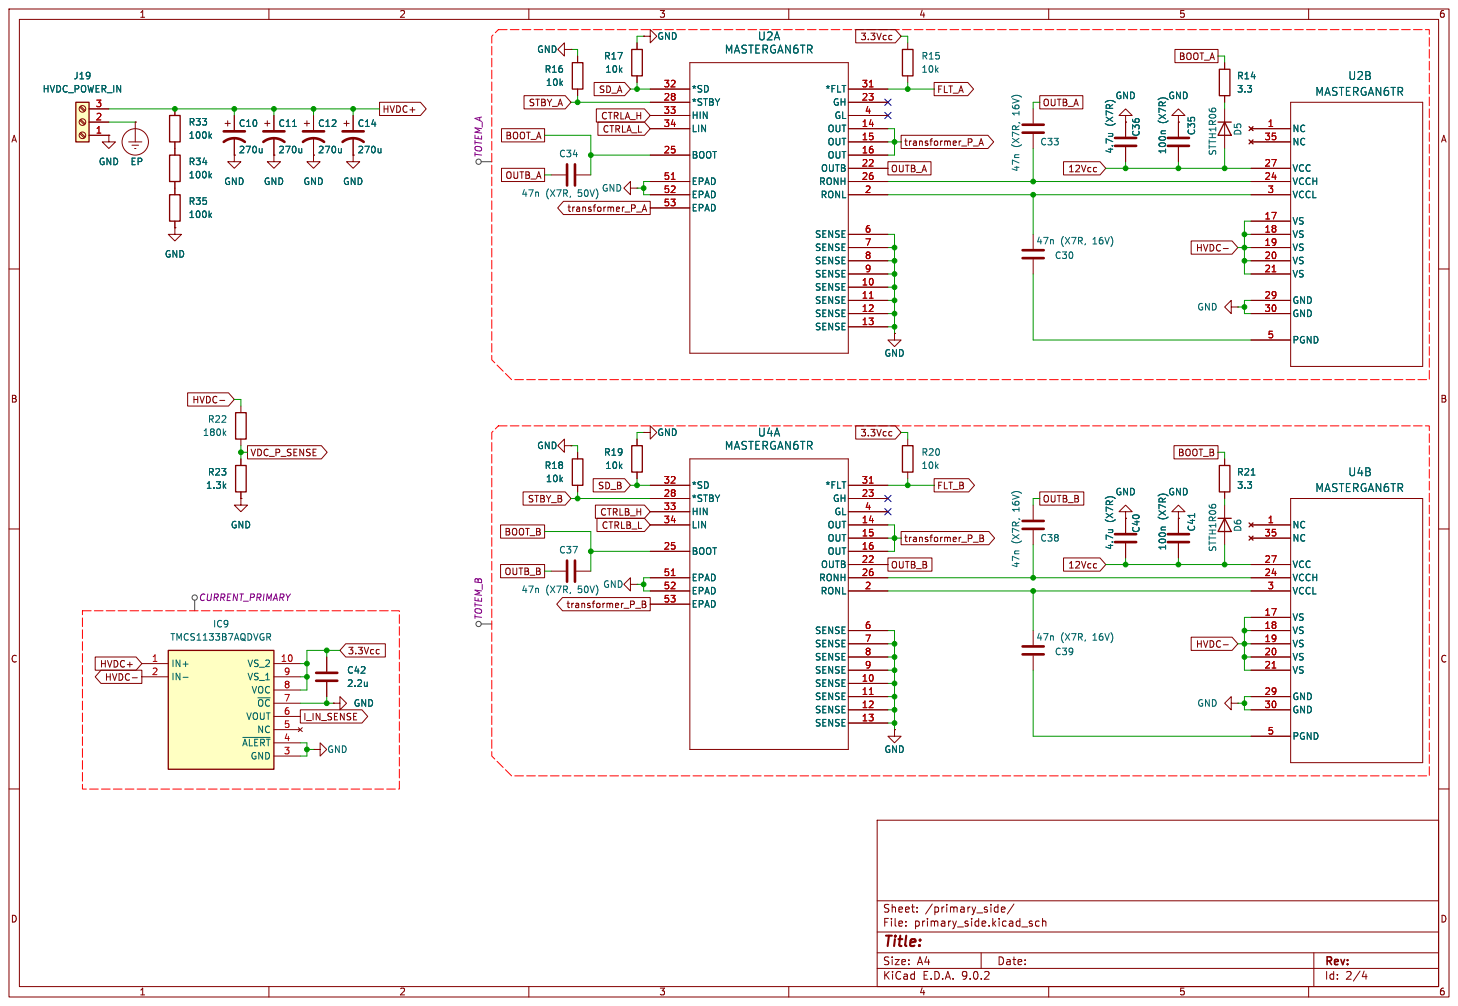
[picture p15: page 2]

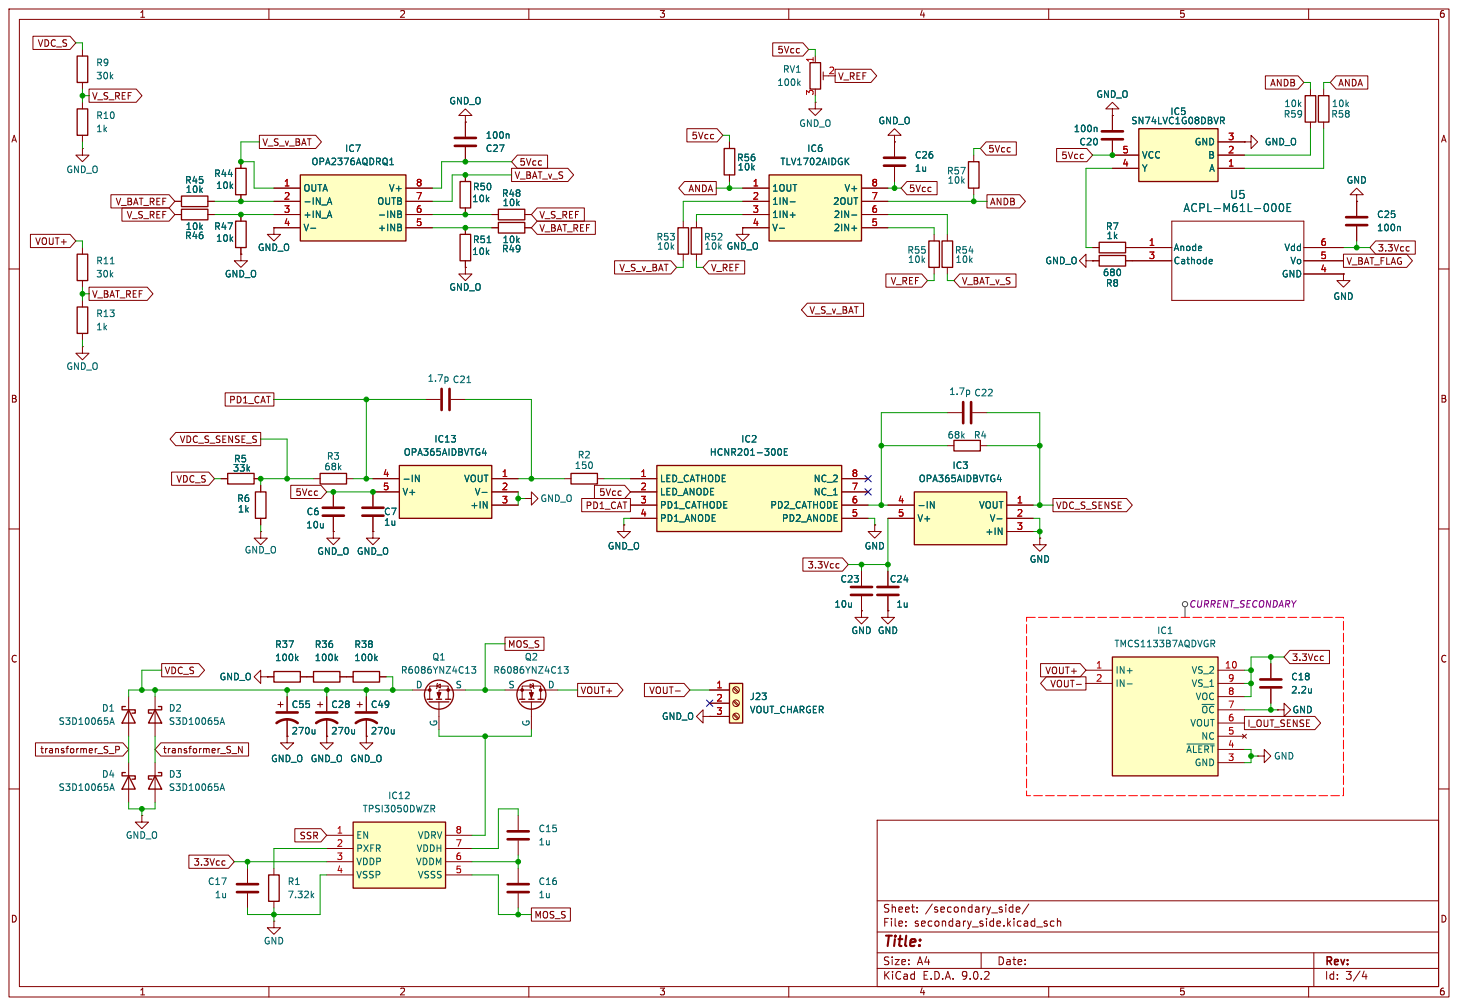
[picture p16: page 3]

Id: 3/4 Title: File: secondary_side.kicad_sch Sheet: /secondary_side/

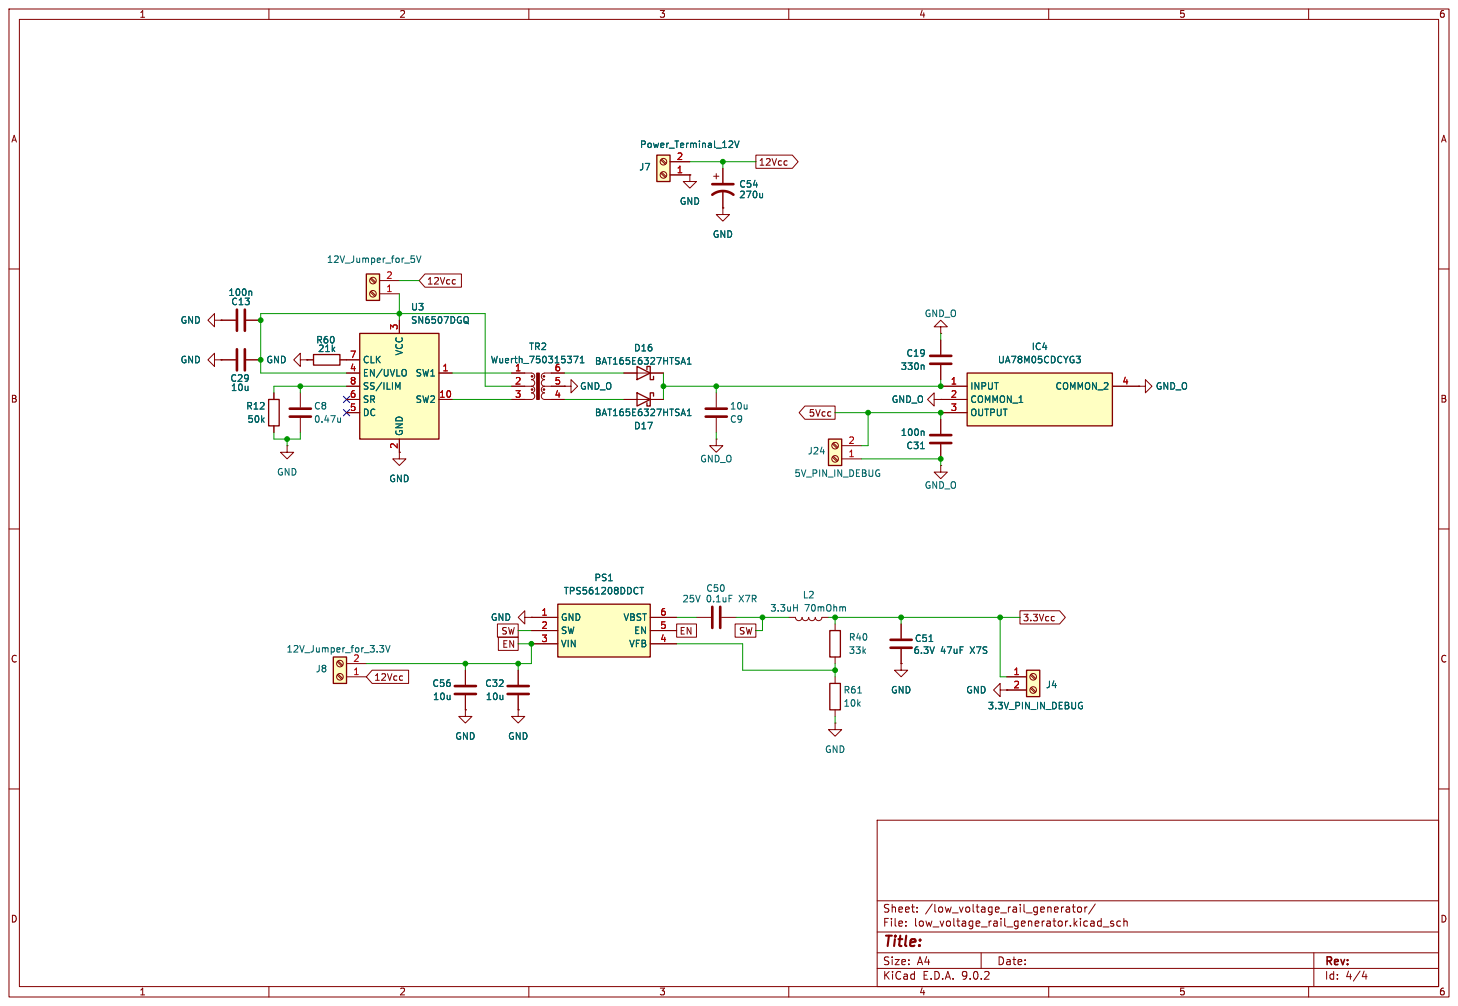
[picture p17: page 4]

Id: 4/4 Title: File: low_voltage_rail_generator.kicad_sch Sheet: /low_voltage_rail_generator/
