oscarse-git/PSFB_1kW_Prototype/PSFB_Operation/PSFB_Operation.asc

C1: cap; 100µ
D1: diode
D2: diode
D3: diode
D4: diode
L1: ind; {L1}; Rser={R1}
L2: ind; {L2}; Rser={R2}
L3: ind; {Ls}
R1: res; {Rload}
S1: sw
S2: sw
S3: sw
S4: sw
V1: voltage; {VDC}
V2: voltage; PULSE(0 1 0 1n 1n {1/(fs*2)} {1/fs})
V3: voltage; PULSE(1 0 0 1n 1n {1/(fs*2)} {1/fs})
V4: voltage; PULSE(0 1 {delay} 1n 1n {1/(fs*2)} {1/fs})
V5: voltage; PULSE(1 0 {delay} 1n 1n {1/(fs*2)} {1/fs})
Named nets: 0, VDC, ctrlA+, ctrlA-, AP, ctrlB+, ctrlB-, BP, AS, BS
.model SW SW(Ron = 1u, Roff = 1Meg, Vt = .5)
k L1 L2 .999
.param VDC = 400
.param Pmax = 1k
.param n = 4
.param fs = 400k
.tran 0 {700/fs} 0
.param phase 90
.param delay = {phase * 1 / (360 * fs)}
.param L1 = 1m
.param L2 = {L1 / (n*n)}
.param R1 = 0.1n
.param R2 = {R1}
.param Ls = 10u
.param V_out_DC = 54
.param Rload = {Pmax / V_out_max_DC}
.param V_out_max_DC = 84
