oscarse-git/PSFB_1kW_Prototype/PSFB_Operation/COMP_Vbat_v_Vpsfb_Operation.asc

A1: and
R1: res; 10k
R2: res; {R1}
R3: res; {R2}
R4: res; 10k
R5: res; 10k
R6: res; {RA}
R7: res; {RB}
R8: res; {RA}
R9: res; {RB}
R10: res; 10k
R11: res; 10k
R12: res; 10k
R13: res; 10k
R14: res; 10k
R15: res; 10k
R16: res; 10k
R17: res; 10k
R18: res; 10k
R19: res; 10k
R20: res; 10k
U1: UniversalOpAmp2
U2: UniversalOpAmp2
U3: UniversalOpAmp2
U4: UniversalOpAmp2
V1: voltage; 5
V2: voltage; PULSE(0 {Vpsfb} 0 .7 0.1n .3 1)
V3: voltage; {Vbat}
Named nets: 0, Vs, Vpsfb, Vbat, Vref, Va, Vb, A-B, B-A, Vout
.tran 0 1 0
.param RA = 30k
.param RB = 1k
.param R1 = 82k
.param R2 = 1k
.param Vbat = 54
.param Vpsfb = 84
