oscarse-git/PSFB_1kW_Prototype/(list of files, drawings)

Other design files:
PSFB_PCB/Components/LIB_RCLAMP0521H.C/RCLAMP0521H.C/Altium/RCLAMP0521H.C.SchLib
PSFB_PCB/Components/LIB_RCLAMP0521H.C/RCLAMP0521H.C/Altium/SOD2513X120N.PcbLib
