oscarse-git/PSFB_1kW_Prototype/PSFB_PCB/PSFB.kicad_pcb

## KiCad design PSFB_PCB/PSFB.kicad_pcb (2026-11-12)

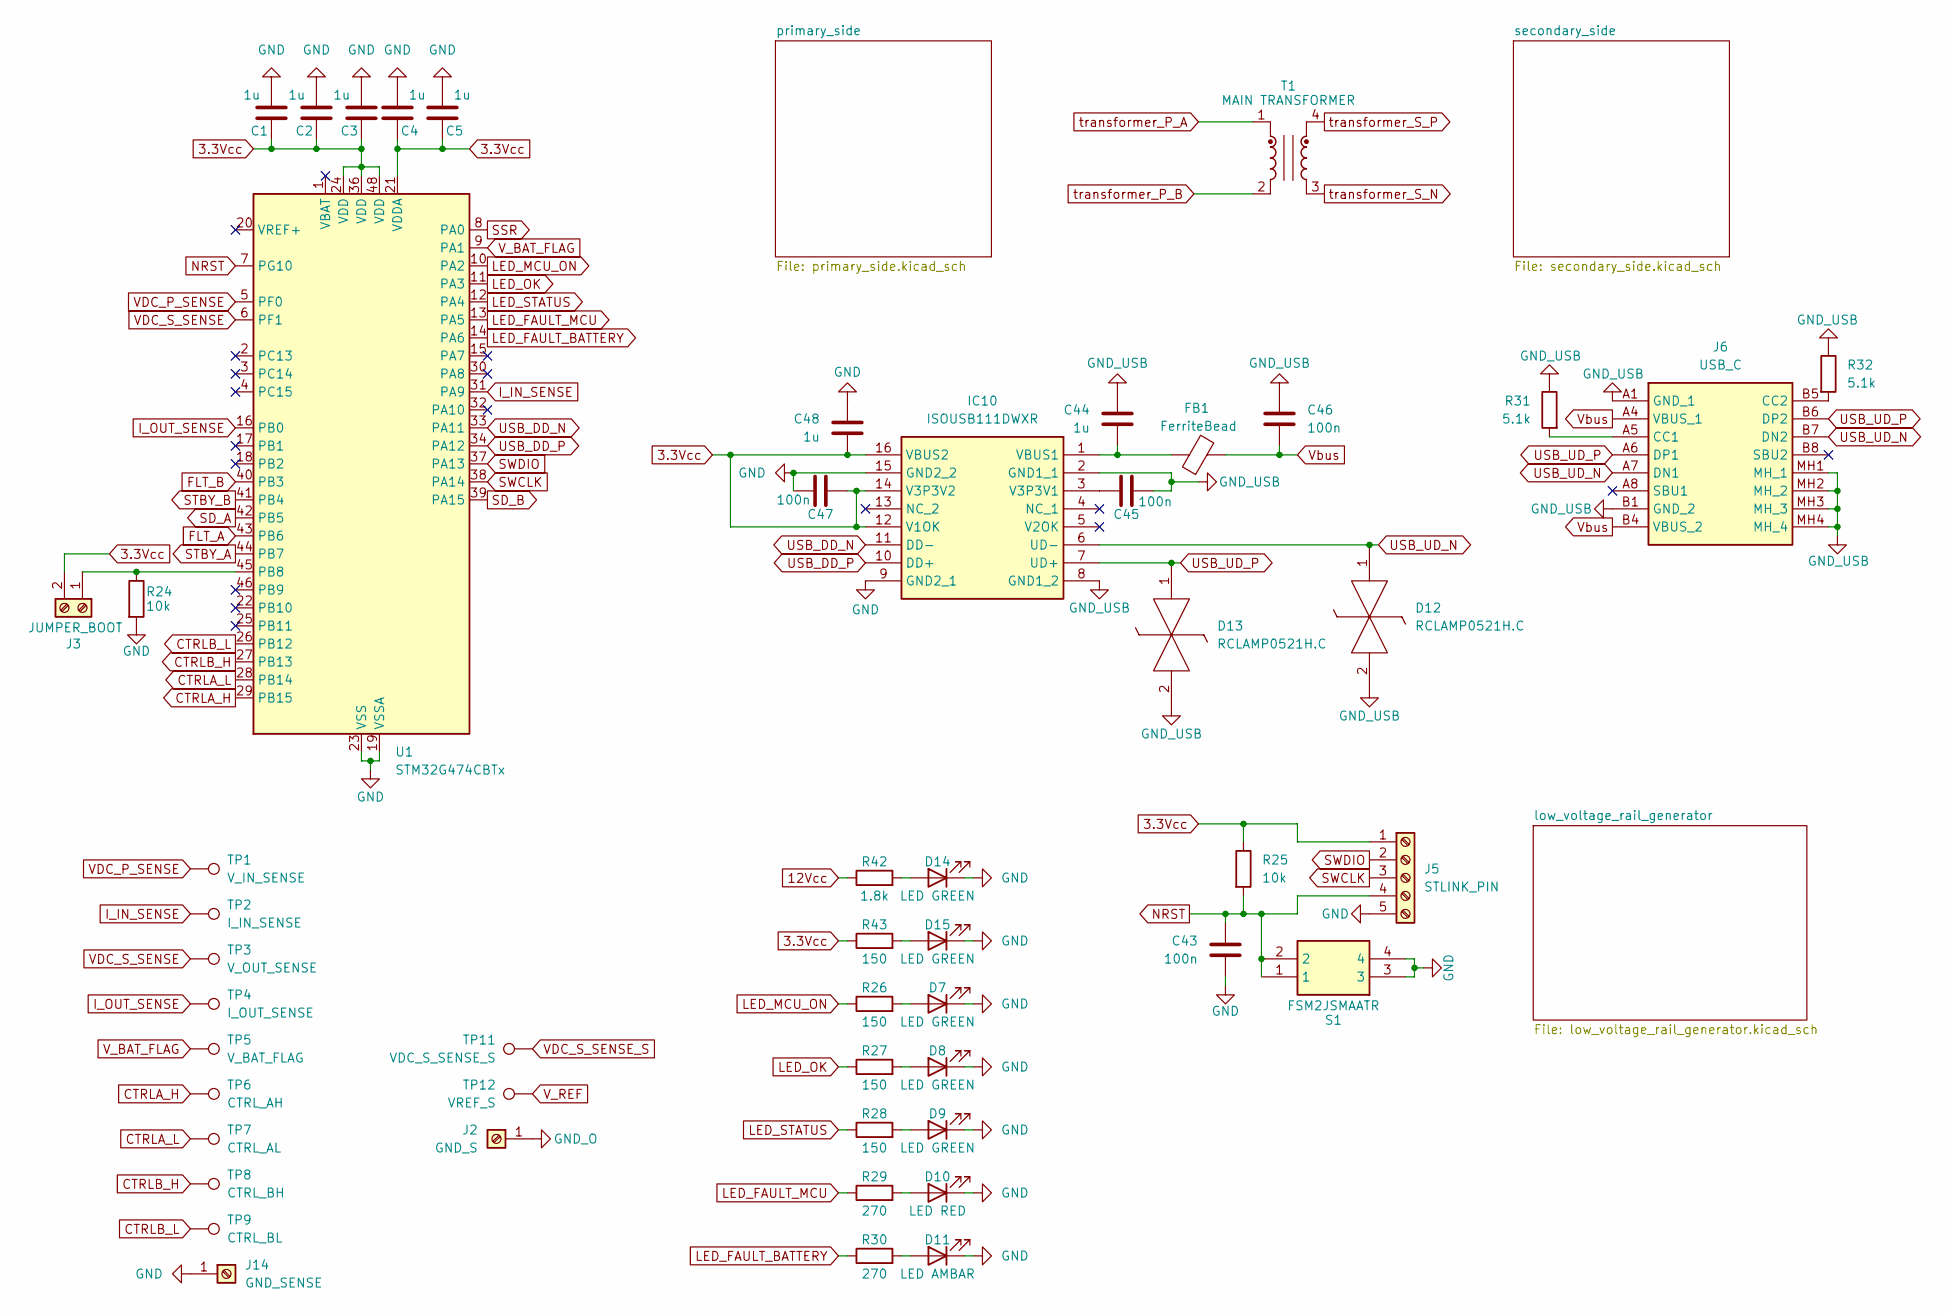
[picture p30: schematic PSFB.kicad_sch, Main PFSB]

Parts:
C1, C2, C3, C4, C5: 1u; C_0603_1608Metric_Pad1.08x0.95mm_HandSolder
C43, C45, C46, C47: 100n; C_1206_3216Metric_Pad1.33x1.80mm_HandSolder
C44, C48: 1u; C_1206_3216Metric_Pad1.33x1.80mm_HandSolder
D7, D8, D9, D14, D15: LED GREEN; LED_0603_1608Metric
D10: LED RED; LED_1206_3216Metric_Pad1.42x1.75mm_HandSolder
D11: LED AMBAR; LED_1206_3216Metric_Pad1.42x1.75mm_HandSolder
D12, D13: RCLAMP0521H.C; SOD2513X120N; Mouser Part Number 947-RCLAMP0521H.C
FB1: FerriteBead; R_0603_1608Metric_Pad0.98x0.95mm_HandSolder
IC10: ISOUSB111DWXR; SOP65P1030X260-16N; Mouser Part Number 595-ISOUSB111DWXR
J2: GND_S; PinHeader_1x01_P2.54mm_Vertical
J3: JUMPER_BOOT; PinHeader_1x02_P2.54mm_Vertical
J5: STLINK_PIN; PinHeader_1x05_P2.54mm_Vertical
J6: USB_C; UJ20CHGMSMT4BP16TR; Manufacturer_Part_Number UJ20-C-H-G-MSMT-4B-P16-TR
J14: GND_SENSE; PinHeader_1x01_P2.54mm_Vertical
R24, R25: 10k; R_0603_1608Metric_Pad0.98x0.95mm_HandSolder
R26, R27, R28, R43: 150; R_0603_1608Metric_Pad0.98x0.95mm_HandSolder
R29, R30: 270; R_0603_1608Metric_Pad0.98x0.95mm_HandSolder
R31, R32: 5.1k; R_0603_1608Metric_Pad0.98x0.95mm_HandSolder
R42: 1.8k; R_0603_1608Metric_Pad0.98x0.95mm_HandSolder
S1: FSM2JSMAATR; FSM2J_1; Mouser Part Number 506-FSM2JSMAATR
T1: MAIN TRANSFORMER; TRANSFORMER_PQ_PSFB
TP1: V_IN_SENSE; TestPoint_Pad_D1.0mm
TP2: I_IN_SENSE; TestPoint_Pad_D1.0mm
TP3: V_OUT_SENSE; TestPoint_Pad_D1.0mm
TP4: I_OUT_SENSE; TestPoint_Pad_D1.0mm
TP5: V_BAT_FLAG; TestPoint_Pad_D1.0mm
TP6: CTRL_AH; TestPoint_Pad_D1.0mm
TP7: CTRL_AL; TestPoint_Pad_D1.0mm
TP8: CTRL_BH; TestPoint_Pad_D1.0mm
TP9: CTRL_BL; TestPoint_Pad_D1.0mm
TP11: VDC_S_SENSE_S; TestPoint_Pad_D1.0mm
TP12: VREF_S; TestPoint_Pad_D1.0mm
U1: STM32G474CBTx; LQFP-48_7x7mm_P0.5mm

Connections:
3.3Vcc: C1.1, C2.1, C3.1, C4.1, C5.1, C47.2, C48.2, IC10.12 (V1OK), IC10.14 (V3P3V2), IC10.16 (VBUS2), J3.2, J5.1, R25.1, R43.1, U1.21 (VDDA), U1.24 (VDD), U1.36 (VDD), U1.48 (VDD); also elsewhere on the board
12Vcc: R42.1; also elsewhere on the board
CTRLA_H: TP6.1, U1.29 (PB15); also elsewhere on the board
CTRLA_L: TP7.1, U1.28 (PB14); also elsewhere on the board
CTRLB_H: TP8.1, U1.27 (PB13); also elsewhere on the board
CTRLB_L: TP9.1, U1.26 (PB12); also elsewhere on the board
FLT_A: U1.43 (PB6); also elsewhere on the board
FLT_B: U1.40 (PB3); also elsewhere on the board
GND: C1.2, C2.2, C3.2, C4.2, C5.2, C43.2, C47.1, C48.1, D7.1 (K), D8.1 (K), D9.1 (K), D10.1 (K), D11.1 (K), D14.1 (K), D15.1 (K), IC10.9 (GND2_1), IC10.15 (GND2_2), J5.5, J14.1, R24.2, S1.3, S1.4, U1.19 (VSSA), U1.23 (VSS), U1.35 (VSS), U1.47 (VSS); also elsewhere on the board
GND_USB: C44.1, C45.1, C46.1, D12.2, D13.2, IC10.2 (GND1_1), IC10.8 (GND1_2), J6.A1 (GND_1), J6.B1 (GND_2), J6.MH1 (MH_1), J6.MH2 (MH_2), J6.MH3 (MH_3), J6.MH4 (MH_4), R31.1, R32.1
I_IN_SENSE: TP2.1, U1.31 (PA9); also elsewhere on the board
I_OUT_SENSE: TP4.1, U1.16 (PB0); also elsewhere on the board
LED_FAULT_BATTERY: R30.1, U1.14 (PA6)
LED_FAULT_MCU: R29.1, U1.13 (PA5)
LED_MCU_ON: R26.1, U1.10 (PA2)
LED_OK: R27.1, U1.11 (PA3)
LED_STATUS: R28.1, U1.12 (PA4)
NRST: C43.1, J5.4, R25.2, S1.1, S1.2, U1.7 (PG10)
unnamed: D7.2 (A), R26.2
unnamed: D8.2 (A), R27.2
unnamed: D9.2 (A), R28.2
unnamed: D10.2 (A), R29.2
unnamed: D11.2 (A), R30.2
unnamed: D14.2 (A), R42.2
unnamed: D15.2 (A), R43.2
unnamed: C45.2, IC10.3 (V3P3V1)
unnamed: C44.2, FB1.1, IC10.1 (VBUS1)
unnamed: J3.1, R24.1, U1.45 (PB8)
unnamed: J6.A5 (CC1), R31.2
unnamed: J6.B5 (CC2), R32.2
SD_A: U1.42 (PB5); also elsewhere on the board
SD_B: U1.39 (PA15); also elsewhere on the board
SSR: U1.8 (PA0); also elsewhere on the board
STBY_A: U1.44 (PB7); also elsewhere on the board
STBY_B: U1.41 (PB4); also elsewhere on the board
SWCLK: J5.3, U1.38 (PA14)
SWDIO: J5.2, U1.37 (PA13)
USB_DD_N: IC10.11 (DD-), U1.33 (PA11)
USB_DD_P: IC10.10 (DD+), U1.34 (PA12)
USB_UD_N: D12.1, IC10.6 (UD-), J6.A7 (DN1), J6.B7 (DN2)
USB_UD_P: D13.1, IC10.7 (UD+), J6.A6 (DP1), J6.B6 (DP2)
VDC_P_SENSE: TP1.1, U1.5 (PF0); also elsewhere on the board
VDC_S_SENSE: TP3.1, U1.6 (PF1); also elsewhere on the board
V_BAT_FLAG: TP5.1, U1.9 (PA1); also elsewhere on the board
V_REF: TP12.1; also elsewhere on the board
Vbus: C46.2, FB1.2, J6.A4 (VBUS_1), J6.B4 (VBUS_2)
transformer_P_A: T1.1; also elsewhere on the board
transformer_P_B: T1.2; also elsewhere on the board
transformer_S_N: T1.3; also elsewhere on the board
transformer_S_P: T1.4; also elsewhere on the board

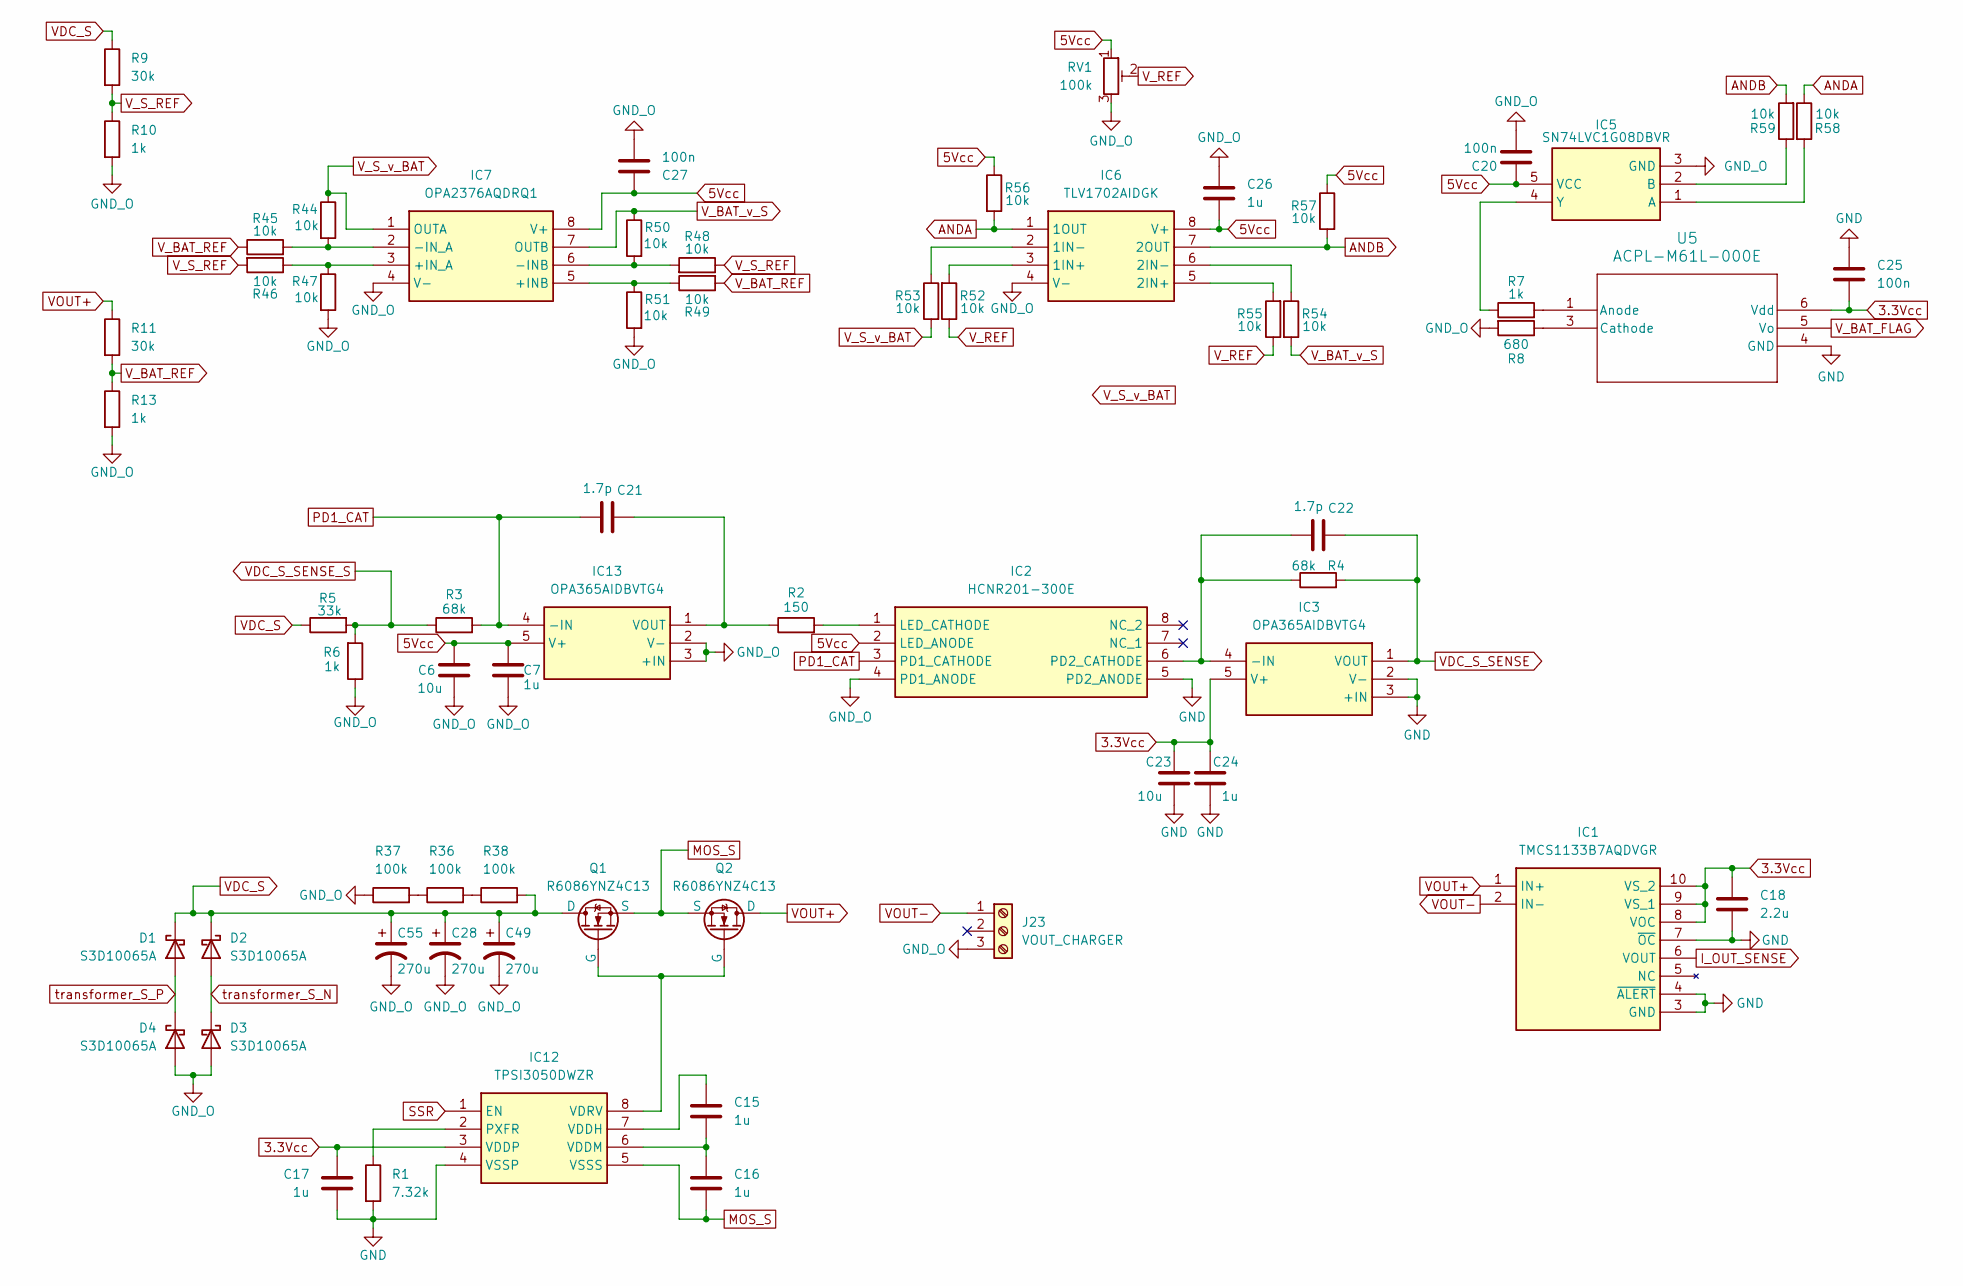
[picture p31: schematic secondary_side.kicad_sch]

Parts:
C6, C23: 10u; C_1206_3216Metric
C7, C15, C16, C17, C24, C26: 1u; C_1206_3216Metric
C18: 2.2u; C_0603_1608Metric_Pad1.08x0.95mm_HandSolder
C20, C25, C27: 100n; C_1206_3216Metric_Pad1.33x1.80mm_HandSolder
C21, C22: 1.7p; C_0603_1608Metric_Pad1.08x0.95mm_HandSolder
C28, C49, C55: 270u; CP_Radial_D25.0mm_P10.00mm_SnapIn
D1, D2, D3, D4: S3D10065A; TO-220-2_Vertical
IC1: TMCS1133B7AQDVGR; Manufacturer_Part_Number TMCS1133B7AQDVGR
IC2: HCNR201-300E; HCNR201300E; Mouser Part Number 630-HCNR201-300E
IC3, IC13: OPA365AIDBVTG4; SOT95P280X145-5N; Mouser Part Number 595-OPA365AIDBVTG4
IC5: SN74LVC1G08DBVR; SOT95P280X145-5N; Mouser Part Number 595-SN74LVC1G08DBVR
IC6: TLV1702AIDGK; SOP65P490X110-8N; Mouser Part Number 595-TLV1702AIDGK
IC7: OPA2376AQDRQ1; SOIC127P600X175-8N; Mouser Part Number 595-OPA2376AQDRQ1
IC12: TPSI3050DWZR; SOIC127P1150X280-8N; Mouser Part Number 595-TPSI3050DWZR
J23: VOUT_CHARGER; 1731734
Q1, Q2: R6086YNZ4C13; TO-247-3_Vertical
R1: 7.32k; R_0603_1608Metric_Pad0.98x0.95mm_HandSolder
R2: 150; R_0805_2012Metric_Pad1.20x1.40mm_HandSolder
R3, R4: 68k; R_0805_2012Metric_Pad1.20x1.40mm_HandSolder
R5: 33k; R_0603_1608Metric_Pad0.98x0.95mm_HandSolder
R6, R7, R10, R13: 1k; R_0603_1608Metric_Pad0.98x0.95mm_HandSolder
R8: 680; R_0603_1608Metric_Pad0.98x0.95mm_HandSolder
R9, R11: 30k; R_0603_1608Metric_Pad0.98x0.95mm_HandSolder
R36, R37, R38: 100k; R_1206_3216Metric_Pad1.30x1.75mm_HandSolder
R44, R45, R46, R47, R48, R49, R50, R51, R52, R53, R54, R55, R56, R57, R58, R59: 10k; R_0603_1608Metric_Pad0.98x0.95mm_HandSolder
RV1: 100k; PVG3A104C01R00
U5: ACPL-M61L-000E; SO-5_AVA-L

Connections:
3.3Vcc: C17.1, C18.1, C23.1, C24.1, C25.2, IC1.8 (VOC), IC1.9 (VS_1), IC1.10 (VS_2), IC3.5 (V+), IC12.3 (VDDP), U5.6 (Vdd); also elsewhere on the board
5Vcc: C6.1, C7.1, C20.1, C26.2, C27.1, IC2.2 (LED_ANODE), IC5.5 (VCC), IC6.8 (V+), IC7.8 (V+), IC13.5 (V+), R56.1, R57.1, RV1.1; also elsewhere on the board
ANDA: IC6.1 (1OUT), R56.2, R58.1
ANDB: IC6.7 (2OUT), R57.2, R59.2
GND: C17.2, C18.2, C23.2, C24.2, C25.1, IC1.3 (GND), IC1.4 (~ALERT), IC1.7 (~OC), IC2.5 (PD2_ANODE), IC3.2 (V-), IC3.3 (+IN), IC12.4 (VSSP), R1.2, U5.4 (GND); also elsewhere on the board
GND_O: C6.2, C7.2, C20.2, C26.1, C27.2, C28.2, C49.2, C55.2, D3.2 (A), D4.2 (A), IC2.4 (PD1_ANODE), IC5.3 (GND), IC6.4 (V-), IC7.4 (V-), IC13.2 (V-), IC13.3 (+IN), J23.3, R6.1, R8.2, R10.2, R13.2, R37.1, R47.2, R51.2, RV1.3; also elsewhere on the board
I_OUT_SENSE: IC1.6 (VOUT); also elsewhere on the board
MOS_S: C16.2, IC12.5 (VSSS), Q1.3 (S), Q2.3 (S)
unnamed: IC2.1 (LED_CATHODE), R2.2
unnamed: C22.2, IC2.6 (PD2_CATHODE), IC3.4 (-IN), R4.1
unnamed: IC5.1 (A), R58.2
unnamed: IC5.2 (B), R59.1
unnamed: IC5.4 (Y), R7.1
unnamed: IC6.3 (1IN+), R52.2
unnamed: IC6.2 (1IN-), R53.1
unnamed: IC6.5 (2IN+), R55.2
unnamed: IC6.6 (2IN-), R54.1
unnamed: IC7.5 (+INB), R49.1, R51.1
unnamed: IC7.3 (+IN_A), R46.1, R47.1
unnamed: IC7.6 (-INB), R48.2, R50.2
unnamed: IC7.2 (-IN_A), R44.2, R45.2
unnamed: IC12.2 (PXFR), R1.1
unnamed: C15.1, IC12.7 (VDDH)
unnamed: C15.2, C16.1, IC12.6 (VDDM)
unnamed: IC12.8 (VDRV), Q1.2 (G), Q2.2 (G)
unnamed: C21.1, IC13.1 (VOUT), R2.1
unnamed: R36.1, R37.2
unnamed: R36.2, R38.1
unnamed: R7.2, U5.1 (Anode)
unnamed: R8.1, U5.3 (Cathode)
PD1_CAT: C21.2, IC2.3 (PD1_CATHODE), IC13.4 (-IN), R3.2
SSR: IC12.1 (EN); also elsewhere on the board
VDC_S: C28.1, C49.1, C55.1, D1.1 (K), D2.1 (K), Q1.1 (D), R5.1, R9.1, R38.2
VDC_S_SENSE: C22.1, IC3.1 (VOUT), R4.2; also elsewhere on the board
VDC_S_SENSE_S: R3.1, R5.2, R6.2
VOUT+: IC1.1 (IN+), Q2.1 (D), R11.1
VOUT-: IC1.2 (IN-), J23.1
V_BAT_FLAG: U5.5 (Vo); also elsewhere on the board
V_BAT_REF: R11.2, R13.1, R45.1, R49.2
V_BAT_v_S: IC7.7 (OUTB), R50.1, R54.2
V_REF: R52.1, R55.1, RV1.2; also elsewhere on the board
V_S_REF: R9.2, R10.1, R46.2, R48.1
V_S_v_BAT: IC7.1 (OUTA), R44.1, R53.2
transformer_S_N: D2.2 (A), D3.1 (K); also elsewhere on the board
transformer_S_P: D1.2 (A), D4.1 (K); also elsewhere on the board

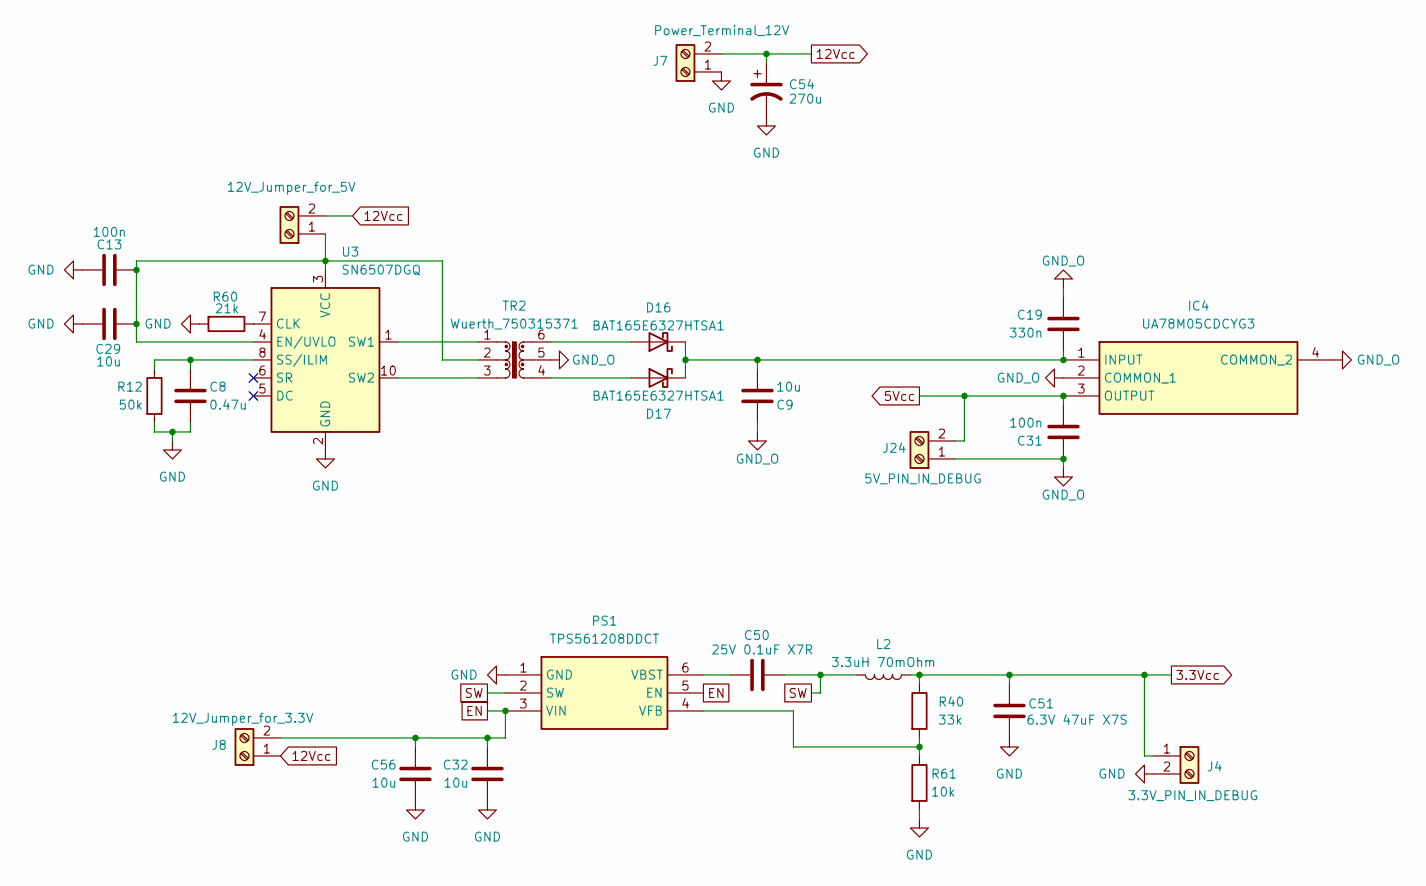
[picture p32: schematic low_voltage_rail_generator.kicad_sch]

Parts:
C8: 0.47u; C_1206_3216Metric_Pad1.33x1.80mm_HandSolder
C9: 10u; C_1206_3216Metric_Pad1.33x1.80mm_HandSolder
C13, C31: 100n; C_1206_3216Metric_Pad1.33x1.80mm_HandSolder
C19: 330n; C_1206_3216Metric_Pad1.33x1.80mm_HandSolder
C29, C32, C56: 10u; C_1206_3216Metric
C50: 25V 0.1uF X7R; C_0805_2012Metric_Pad1.18x1.45mm_HandSolder
C51: 6.3V 47uF X7S; C_1206_3216Metric_Pad1.33x1.80mm_HandSolder
C54: 270u; CP_Radial_D25.0mm_P10.00mm_SnapIn
D16, D17: BAT165E6327HTSA1; D_SOD-323
IC4: UA78M05CDCYG3; SOT230P700X180-4N; Mouser Part Number 595-UA78M05CDCYG3
J1: 12V_Jumper_for_5V; PinHeader_1x02_P2.54mm_Vertical
J4: 3.3V_PIN_IN_DEBUG; PinHeader_1x02_P2.54mm_Vertical
J7: Power_Terminal_12V; 15465512
J8: 12V_Jumper_for_3.3V; PinHeader_1x02_P2.54mm_Vertical
J24: 5V_PIN_IN_DEBUG; PinHeader_1x02_P2.54mm_Vertical
L2: 3.3uH 70mOhm; 784777033
PS1: TPS561208DDCT; SOT95P280X110-6N; Mouser Part Number 595-TPS561208DDCT
R12: 50k; R_1206_3216Metric_Pad1.30x1.75mm_HandSolder
R40: 33k; R_0603_1608Metric_Pad0.98x0.95mm_HandSolder
R60: 21k; R_1206_3216Metric_Pad1.30x1.75mm_HandSolder
R61: 10k; R_0603_1608Metric_Pad0.98x0.95mm_HandSolder
TR2: Wuerth_750315371; Transformer_Wuerth_750315371
U3: SN6507DGQ; HVSSOP-10-1EP_3x3mm_P0.5mm_EP1.57x1.88mm

Connections:
3.3Vcc: C51.1, J4.1, L2.1, R40.1; also elsewhere on the board
5Vcc: C31.2, IC4.3 (OUTPUT), J24.2; also elsewhere on the board
12Vcc: C54.1, J1.2, J7.2, J8.1; also elsewhere on the board
EN: C32.1, C56.1, J8.2, PS1.3 (VIN), PS1.5 (EN)
GND: C8.2, C13.1, C29.1, C32.2, C51.2, C54.2, C56.2, J4.2, J7.1, PS1.1 (GND), R12.2, R60.2, R61.2, U3.2 (GND), U3.9 (GND), U3.11 (GND); also elsewhere on the board
GND_O: C9.1, C19.1, C31.1, IC4.2 (COMMON_1), IC4.4 (COMMON_2), J24.1, TR2.5; also elsewhere on the board
unnamed: D16.2 (A), TR2.6
unnamed: C9.2, C19.2, D16.1 (K), D17.1 (K), IC4.1 (INPUT)
unnamed: D17.2 (A), TR2.4
unnamed: C13.2, C29.2, J1.1, TR2.2, U3.3 (VCC), U3.4 (EN/UVLO)
unnamed: C50.2, PS1.6 (VBST)
unnamed: PS1.4 (VFB), R40.2, R61.1
unnamed: R60.1, U3.7 (CLK)
unnamed: C8.1, R12.1, U3.8 (SS/ILIM)
unnamed: TR2.1, U3.1 (SW1)
unnamed: TR2.3, U3.10 (SW2)
SW: C50.1, L2.2, PS1.2 (SW)

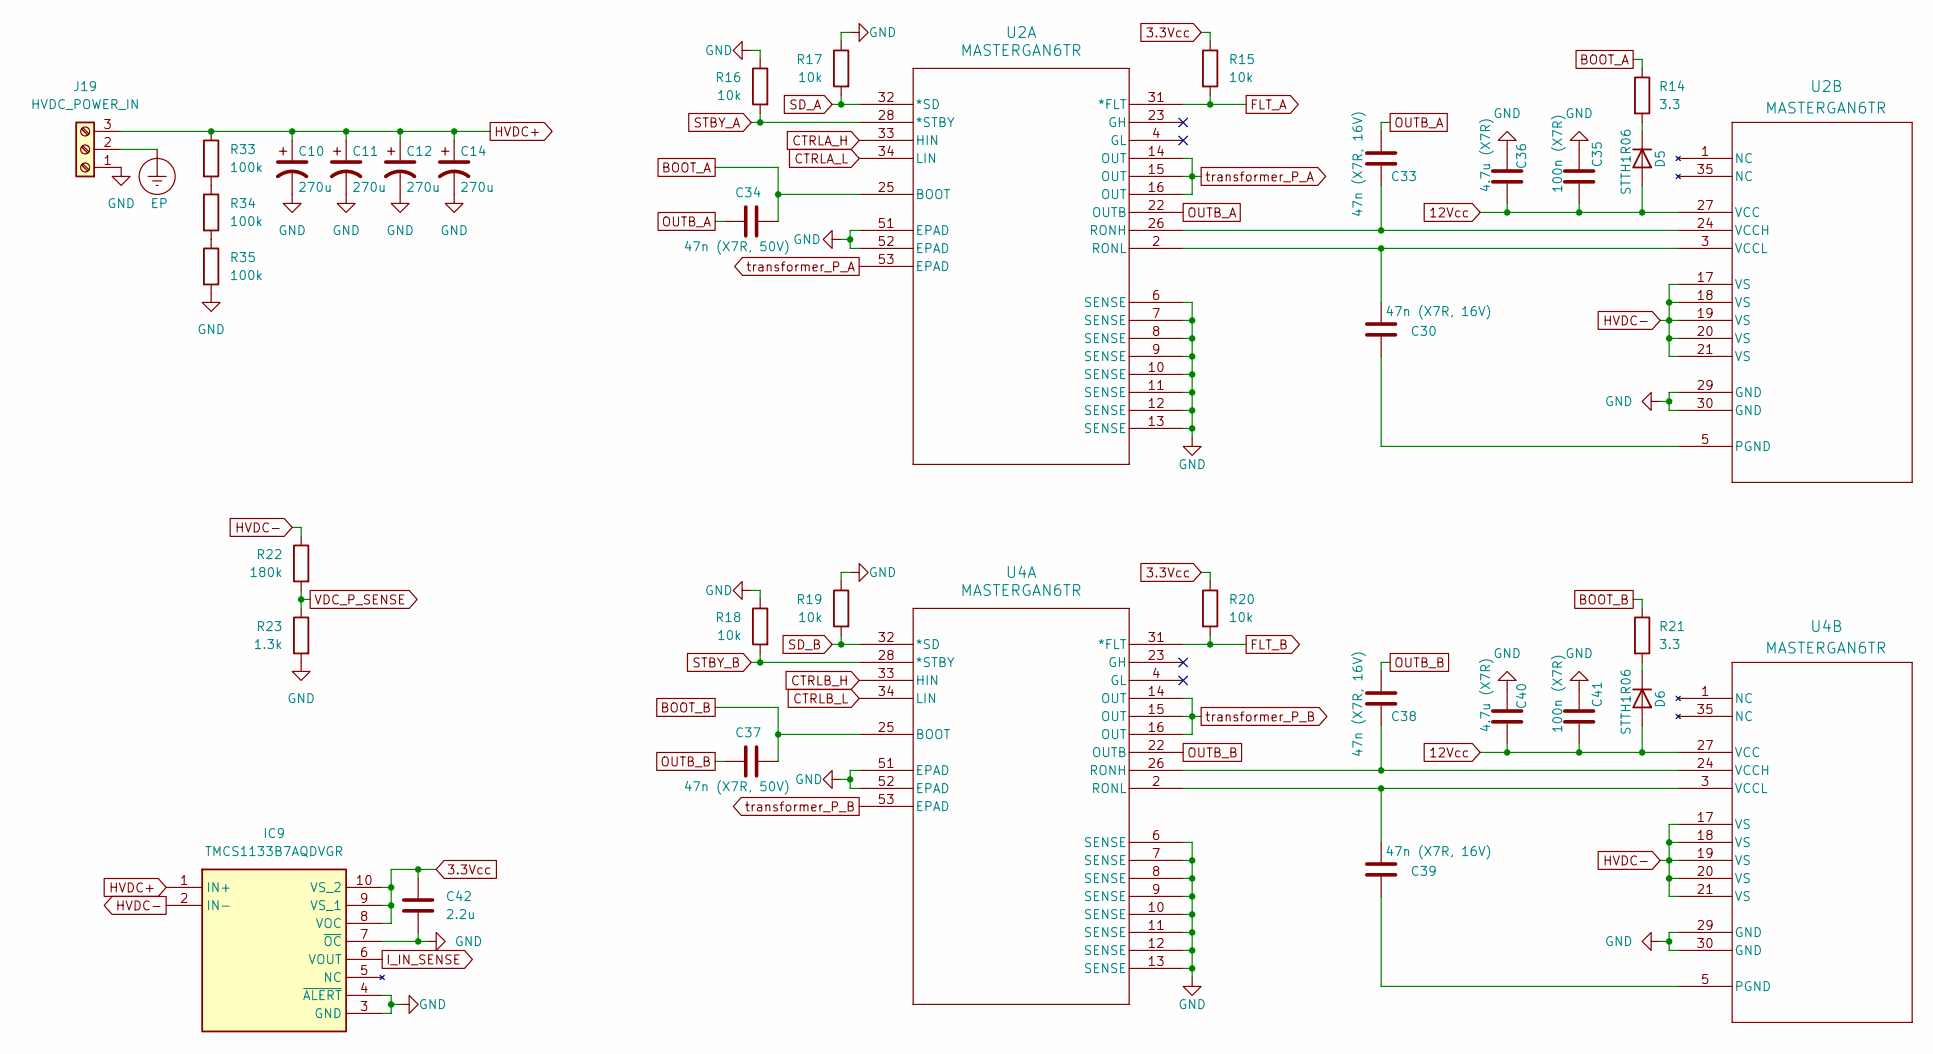
[picture p33: schematic primary_side.kicad_sch]

Parts:
C10, C11, C12, C14: 270u; CP_Radial_D25.0mm_P10.00mm_SnapIn
C30, C33, C38, C39: 47n (X7R, 16V); C_0402_1005Metric
C34, C37: 47n (X7R, 50V); C_0603_1608Metric
C35, C41: 100n (X7R); C_0603_1608Metric_Pad1.08x0.95mm_HandSolder
C36, C40: 4.7u (X7R); C_1206_3216Metric_Pad1.33x1.80mm_HandSolder
C42: 2.2u; C_0603_1608Metric_Pad1.08x0.95mm_HandSolder
D5, D6: STTH1R06; DIOM5126X265N
IC9: TMCS1133B7AQDVGR; Manufacturer_Part_Number TMCS1133B7AQDVGR
J19: HVDC_POWER_IN; 1731734
R14, R21: 3.3; R_0805_2012Metric_Pad1.20x1.40mm_HandSolder
R15, R16, R17, R18, R19, R20: 10k; R_0603_1608Metric_Pad0.98x0.95mm_HandSolder
R22: 180k; R_1206_3216Metric_Pad1.30x1.75mm_HandSolder
R23: 1.3k; R_1206_3216Metric_Pad1.30x1.75mm_HandSolder
R33, R34, R35: 100k; R_1206_3216Metric_Pad1.30x1.75mm_HandSolder
U2, U4: MASTERGAN6TR; QFN35_9X9_STM-M

Connections:
3.3Vcc: C42.1, IC9.8 (VOC), IC9.9 (VS_1), IC9.10 (VS_2), R15.1, R20.1; also elsewhere on the board
12Vcc: C35.2, C36.2, C40.2, C41.2, D5.2 (A), D6.2 (A), U2.27 (VCC), U4.27 (VCC); also elsewhere on the board
BOOT_A: C34.2, R14.1, U2.25 (BOOT)
BOOT_B: C37.2, R21.1, U4.25 (BOOT)
CTRLA_H: U2.33 (HIN); also elsewhere on the board
CTRLA_L: U2.34 (LIN); also elsewhere on the board
CTRLB_H: U4.33 (HIN); also elsewhere on the board
CTRLB_L: U4.34 (LIN); also elsewhere on the board
EP: J19.2
FLT_A: R15.2, U2.31 (*FLT); also elsewhere on the board
FLT_B: R20.2, U4.31 (*FLT); also elsewhere on the board
GND: C10.2, C11.2, C12.2, C14.2, C35.1, C36.1, C40.1, C41.1, C42.2, IC9.3 (GND), IC9.4 (~ALERT), IC9.7 (~OC), J19.1, R16.1, R17.1, R18.1, R19.1, R23.2, R35.2, U2.6 (SENSE), U2.7 (SENSE), U2.8 (SENSE), U2.9 (SENSE), U2.10 (SENSE), U2.11 (SENSE), U2.12 (SENSE), U2.13 (SENSE), U2.29 (GND), U2.30 (GND), U2.51 (EPAD), U2.52 (EPAD), U4.6 (SENSE), U4.7 (SENSE), U4.8 (SENSE), U4.9 (SENSE), U4.10 (SENSE), U4.11 (SENSE), U4.12 (SENSE), U4.13 (SENSE), U4.29 (GND), U4.30 (GND), U4.51 (EPAD), U4.52 (EPAD); also elsewhere on the board
HVDC+: C10.1, C11.1, C12.1, C14.1, IC9.1 (IN+), J19.3, R33.1
HVDC-: IC9.2 (IN-), R22.1, U2.17 (VS), U2.18 (VS), U2.19 (VS), U2.20 (VS), U2.21 (VS), U4.17 (VS), U4.18 (VS), U4.19 (VS), U4.20 (VS), U4.21 (VS)
I_IN_SENSE: IC9.6 (VOUT); also elsewhere on the board
unnamed: D5.1 (K), R14.2
unnamed: D6.1 (K), R21.2
unnamed: R33.2, R34.1
unnamed: R34.2, R35.1
unnamed: C33.2, U2.24 (VCCH), U2.26 (RONH)
unnamed: C30.1, U2.2 (RONL), U2.3 (VCCL)
unnamed: C30.2, U2.5 (PGND)
unnamed: C38.2, U4.24 (VCCH), U4.26 (RONH)
unnamed: C39.1, U4.2 (RONL), U4.3 (VCCL)
unnamed: C39.2, U4.5 (PGND)
OUTB_A: C33.1, C34.1, U2.22 (OUTB)
OUTB_B: C37.1, C38.1, U4.22 (OUTB)
SD_A: R17.2, U2.32 (*SD); also elsewhere on the board
SD_B: R19.2, U4.32 (*SD); also elsewhere on the board
STBY_A: R16.2, U2.28 (*STBY); also elsewhere on the board
STBY_B: R18.2, U4.28 (*STBY); also elsewhere on the board
VDC_P_SENSE: R22.2, R23.1; also elsewhere on the board
transformer_P_A: U2.14 (OUT), U2.15 (OUT), U2.16 (OUT), U2.53 (EPAD); also elsewhere on the board
transformer_P_B: U4.14 (OUT), U4.15 (OUT), U4.16 (OUT), U4.53 (EPAD); also elsewhere on the board

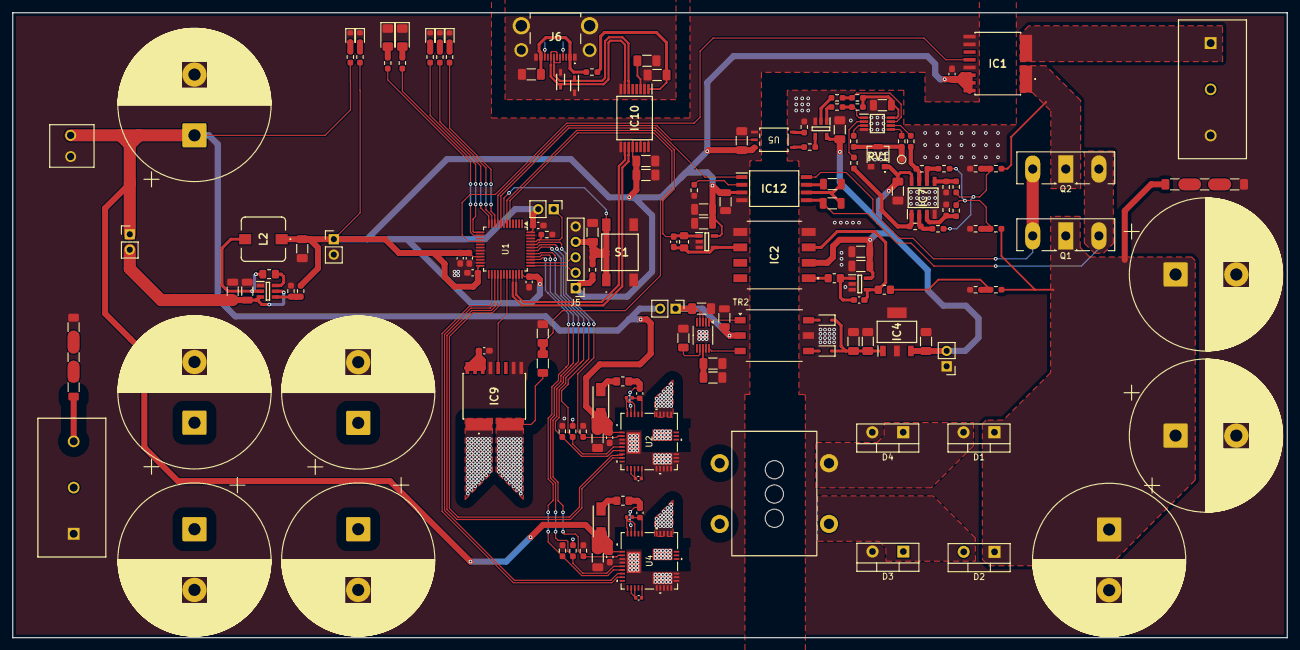
[picture p34: board PSFB.kicad_pcb from above]

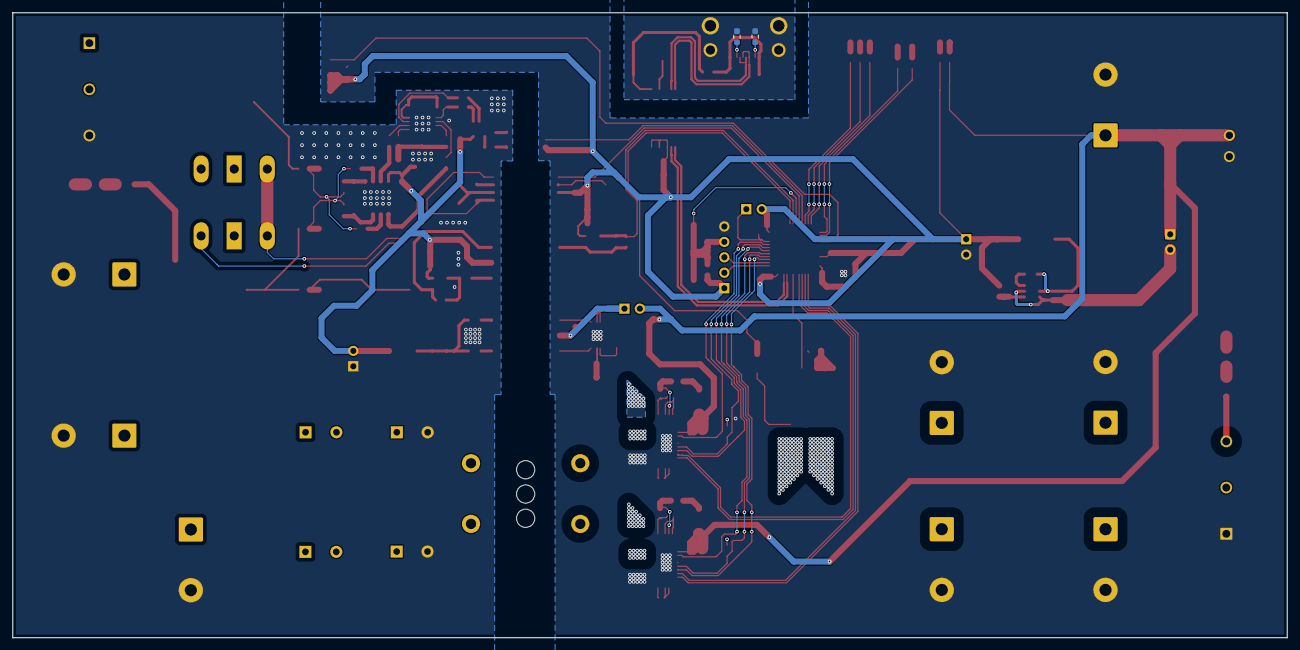
[picture p35: board PSFB.kicad_pcb from below]

Board: 4 copper layers, 209.9 x 102.9 mm, 166 parts (2 on the bottom side), 114 nets.
